LeBaptCode/PolySource/README.md

<h1> PolySource </h1>
<p>Année 2025-2026</p>
<p>Projet ELSE4 FISA Polytech Nice Sophia </p>

<p>Objectif: 
    <ul>
    <li>Monitoring d'une source</li>
    <li>mesure de hauteur d'eau</li>
    <li>mesure de débit</li>
    <li>détection de trop plein</li>
    <li>publication des mesures sur page web (GSM, MQTT, ...)</li>
    <li>gestion de l'énergie pour maximiser l’autonomie</li></ul></p>
