LeBaptCode/PolySource/RESSOURCES/Tuto/README.md

# Repertoir de tutoriels

Ce dossier contient les tutoriels de configurations des différents éléments du projet:

- Configuration du Raspberry Pi 5 pour héberger le serveur web et les services Telegraf et Grafana.
- Configuration du module GSM USR-DR154 pour qu'il puisse se connecter au broker MQTT HiveMQ Cloud et envoyer des données.
