LeBaptCode/PolySource/DOCS/AndyCLEMENT/Compte-Rendu-17.md

# Compte Rendu Semaine 14 / W17 (24/04/2026)

## Concevoir le tuto pour la configuration du module GSM USR-DR154

Puisqu'aujourd'hui, est la dernère séance de l'année, nous avons décidé de concevoir un tutoriel pour expliquer comment configurer le module GSM USR-DR154 pour que le groupe suivant puisse continuer le projet et avancer plus vite. Le tutoriel explique comment configurer le module GSM pour qu'il puisse se connecter au broker MQTT HiveMQ Cloud et envoyer des données. Le tutoriel est disponible sur le dépôt GitHub du projet, dans le dossier Ressource/tuto.

## Mise à jour du code

Mathis a modifer le code de l'ESP32 pour régler le problème du sonar. Il a réussi a avoir un code fonctionnel

## Prochaine séance

Continuer à travaille sur le code.
