LeBaptCode/PolySource/DOCS/BaptisteLECLERC/Seance11.md

# Séance du 19/02/2026

## 🎯 Objectifs de la séance

* Restaurer et stabiliser l'environnement système de la Raspberry Pi.

---
## 🛠️ Réalisations 

### Diagnostic et Résolution d'Incidents Système
La séance a été principalement consacrée à la résolution d'instabilités système majeures sur la Raspberry Pi :

* **Conflit d'Horloge & InfluxDB :** Un décalage critique de la date et de l'heure système empêchait le démarrage du service `InfluxDB`. Ce type de base de données "séries temporelles" requiert une synchronisation parfaite pour fonctionner.
* **Corruption suite au changement de localisation :** Une tentative de reconfiguration de la localisation (*locale*) a entraîné la perte de l'interface graphique  et la suppression accidentelle de répertoires du projet.
* **Restauration complète :** Afin de garantir la stabilité future, j'ai procédé à une réinstallation et une reconfiguration complète du système d'exploitation.

### Gestion des Sauvegardes et Reprise d'Activité
* **Analyse Post-Incident :** Malgré l'absence de mise à jour récente sur `GitHub`, j'ai pu m'appuyer sur une sauvegarde récente.
* **Réactivité :** Ma documentation des étapes de configuration précédentes a permis une réinstallation rapide des services et une réécriture efficace des dernières modifications.
* **État final :** À l'issue de la séance, la chaîne de données complète (`MQTT` → `Telegraf` → `InfluxDB` → `Grafana`) est de nouveau pleinement opérationnelle.

---

## ➡️ Prochaine séance

* **Cahier des charges PCB :** Lister les contraintes techniques pour la conception de la carte électronique :
    * Schéma d'intégration des composants (ESP32, capteurs, régulateurs).
    * Définition des dimensions et du boîtier pour garantir l'étanchéité et la protection en milieu extérieur.
