LeBaptCode/PolySource/DOCS/README.md

Ici sont stockés les rapports individuels de chacun des membres
