LeBaptCode/PolySource/RESSOURCES/Data-Sheet/README.md

# Ici sont stockés les datasheet de nos composants
