LeBaptCode/PolySource/DOCS/AndyCLEMENT/README.md

<h1> Depot personnel</h1>
<p> Ici sera stocké les rapports de Andy CLEMENT concernant le projet</p>
