LeBaptCode/PolySource/DOCS/MatthisGOMEZ/README.md

Ici je vais rentrer l'avancée de mes travaux personnels (même les tentatives et explorations de thème qui se sont soldées par un échec).
