LeBaptCode/PolySource/DOCS/AndyCLEMENT/Images/README.md

<h1>Ici sont stockés toute les images utilisées dans les rapports</h1>
