LeBaptCode/PolySource/DOCS/MatthisGOMEZ/ZSeance15.md

Le but cette fois-ci a été de faire un test en "condition réelle" avec : 
le gsm qui envoie les données en format json du sonar et du débit-mètre au broker en mqtt.

Verdict : test réussi, on a un projet fonctionnel.

Probleme : seulement un des deux gsm fonctionne nous n'avons pas trouvé le moyen de configurer le second.

Nous avons donc créer un tutoriel pour les prochaines personnes qui devront travailler sur le projet, ainsi il sera plus simple pour eux de configurer le gsm usr dsr4.
