LeBaptCode/PolySource/DOCS/BaptisteLECLERC/Seance15.md

# Séance du 10/04/2026

## 🎯 Objectifs de la séance
* Audit de performance et de stabilité.
* Optimiser l'interface utilisateur (UI) pour différentes tailles d'écran.

---

## 🛠️ Réalisations 

### Audit de performance et stabilité
Suite aux interventions thermiques des séances précédentes, j'ai effectué une phase de surveillance pour valider la robustesse de l'installation :
* **Analyse des ressources (htop) :** Surveillance de la charge CPU et de l'occupation mémoire. Aucun "memory leak" ni processus anormal n'a été détecté. 
* **Validation thermique :** Grafana est resté actif durant toute la séance sans provoquer de ralentissements. Le ventilateur n'est peut-être pas nécessaire pour les conditions actuelles, je ferai le test lors de la prochaine séance.

### Validation de la chaîne de données
* **Validation de l'interopérabilité "End-to-End" :** Lors des essais d'émission MQTT effectués par Andy, j'ai supervisé le flux de données sur l'ensemble de la stack technique. Ce test a confirmé le bon fonctionnement de toute la chaîne : la réception par le broker, le parsing via Telegraf, l'archivage dans InfluxDB et l'affichage dynamique en temps réel sur Grafana.

### Optimisation de l'interface (Responsive Design)
Pour garantir une exploitation optimale des données sur le terrain :
* **Adaptabilité du Dashboard :** J'ai retravaillé l'agencement des panneaux Grafana pour les rendre **responsives**. 
* **Flexibilité d'affichage :** Les grilles de visualisation s'adaptent désormais automatiquement à la taille de l'écran. Des tests complémentaires seront à prévoir sur différents écrans pour valider les points de rupture d'affichage.

---

## ➡️ Prochaine séance

* **Automatisation de la configuration :** Développement d'un script de déploiement automatique pour l'installation des dépendances système (Docker, outils de monitoring).
    * Finalisation du fichier `docker-compose.yml` pour permettre un déploiement "en un clic" de la stack T.I.G. (Telegraf, InfluxDB, Grafana).
* **Dossier de transfert et reproductibilité :**  Rédaction d'un guide `README.md` détaillant les étapes de mise en service à partir d'une installation vierge.
    * L'objectif est de garantir que le projet puisse être intégralement récupéré et déployé par un tiers en un minimum de temps.
