LeBaptCode/PolySource/DOCS/BaptisteLECLERC/Seance2.md

# Séance du 23/10/2025

## Objectif de la séance
Durant cette séance, j’ai poursuivi mes recherches sur la stack que nous allons utiliser pour l’interface web.

## Choix technologiques

### Hébergement et base de données
Nous avons choisi d’utiliser **Firebase** de **Google**, car il permet d’héberger gratuitement le site internet tout en offrant une base de données intégrée au même endroit.  
Ainsi, **Firebase** sera utilisé pour le **backend** du projet.

### Interface web (Frontend)
Pour la partie **frontend**, nous avons décidé d’utiliser **Vue.js**, un framework JavaScript léger et parfaitement adapté à notre cas d’usage.

### Librairies et composants
J’ai également recherché des librairies utiles pour les différents composants de l’interface.  
Je m’oriente vers la librairie **[shadcn/ui](https://ui.shadcn.com/)** pour la partie **UI**, car elle propose des composants déjà prêts, personnalisables, et visuellement cohérents.

Pour l’affichage des graphiques, je compte utiliser **[Chart.js](https://www.chartjs.org/)**, une librairie populaire et simple d’utilisation.

## Prochaine séance
Lors de la prochaine séance, je vais :
- Continuer la mise en place du projet.  
- Ajouter les différentes librairies nécessaires.  
- Commencer la conception du dashboard.
