LeBaptCode/PolySource/DOCS/BaptisteLECLERC/images/grafana_dashboard.png

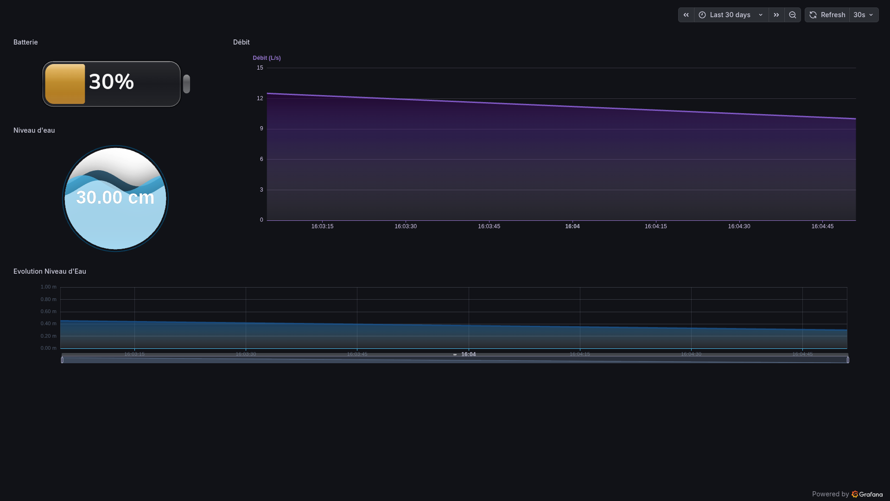
DOCS/BaptisteLECLERC/images/grafana_dashboard.png
