LeBaptCode/PolySource/DOCS/BaptisteLECLERC/images/hiveMq_Cloud.png

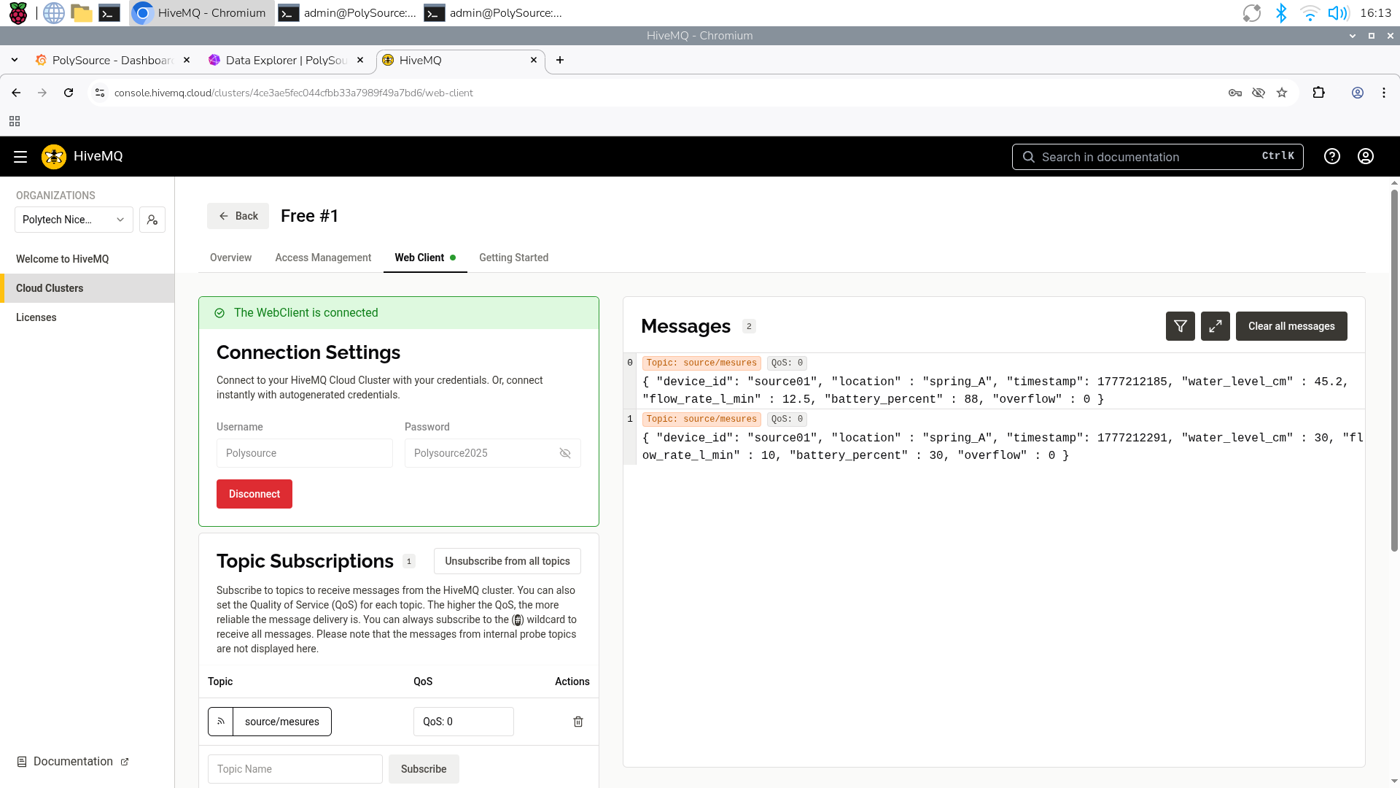
DOCS/BaptisteLECLERC/images/hiveMq_Cloud.png
