LeBaptCode/PolySource/DOCS/MatthisGOMEZ/1000021461.jpg

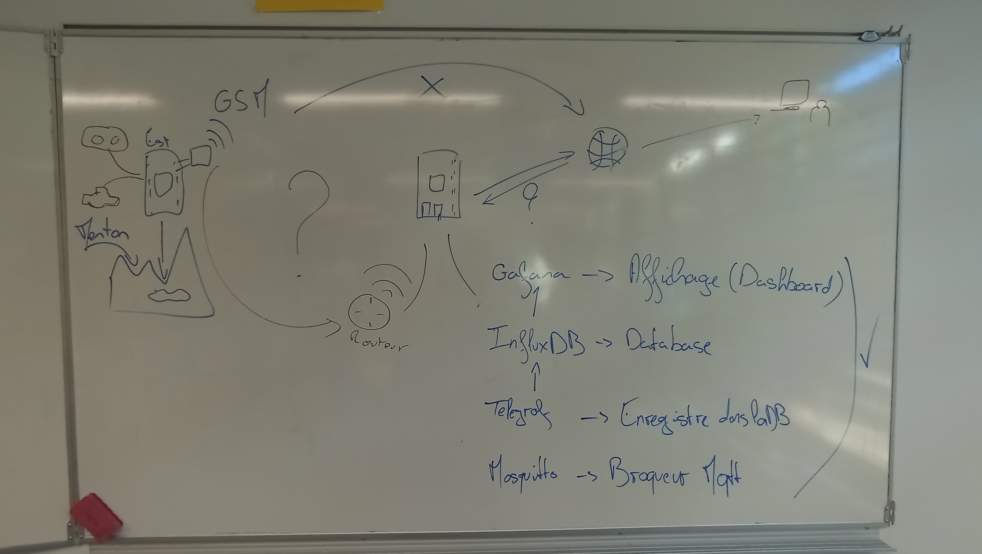
DOCS/MatthisGOMEZ/1000021461.jpg
