LeBaptCode/PolySource/RESSOURCES/Data-Sheet/Data-Sheet-DebitMetre.png

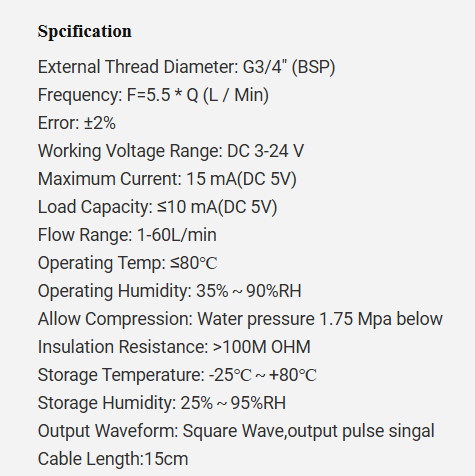
RESSOURCES/Data-Sheet/Data-Sheet-DebitMetre.png
