LeBaptCode/PolySource/ECOCONCEPTION/ecoconception_ACV.xlsx

Sheet: Bilan CO2eq Synthèse
BILAN ÉCOCONCEPTION — Empreinte Carbone Fabrication (Scope 3)
Méthode : ACV cradle-to-gate (ISO 14040/14044) | Scope 3 amont (fabrication) | Sources : ADEME Base Carbone, Ecoinvent 3.9, Littérature scientifique
Référentiel des facteurs d'émission utilisés
Catégorie de matériau / composant | Facteur CO2eq | Unité | Source
PCB basique (carte mère TV basique) | 444.0 | kg CO2eq/m² | ADEME Base Carbone
PCB dense / connecté (contrôleur LCD, carte connectée) | 866.0 | kg CO2eq/m² | ADEME Base Carbone
Wafer silicium — circuits intégrés (semi-conducteurs) | 5000.0 | kg CO2eq/m² | Littérature scientif. (200-27 000 MJ/cm², ~0,4 kgCO2/MJ)
Circuit intégré logique / réseau (par masse) | 80.7 | kg CO2eq/kg | ADEME Base Carbone / Boavizta
Composants passifs CMS (résistances, condensateurs, inductances) | 15.0 | kg CO2eq/kg | Ecoinvent 3.9
Connecteurs électroniques | 15.0 | kg CO2eq/kg | Ecoinvent 3.9
Plastiques injectés ABS / POM / PVC | 3.5 | kg CO2eq/kg | Ecoinvent 3.9
Caoutchouc synthétique EPDM | 3.2 | kg CO2eq/kg | Ecoinvent 3.9
Laiton (corps mécanique) | 3.8 | kg CO2eq/kg | Ecoinvent 3.9
Néodyme — terres rares (aimant NdFeB) | 35.0 | kg CO2eq/kg | Ecoinvent 3.9
Aluminium usiné primaire (électrolyse Hall-Héroult) | 14.5 | kg CO2eq/kg | Ecoinvent 3.9
Câble cuivre + isolant PVC | 5.0 | kg CO2eq/kg | Ecoinvent 3.9
Acier inoxydable | 2.0 | kg CO2eq/kg | Ecoinvent 3.9
Bilan CO2eq par carte / bloc fonctionnel (fabrication)
Composant / Carte | Référence | CO2eq estimé (kg CO2eq) | Part du système (%) | Principaux drivers d'impact | Levier d'écoconception prioritaire
ESP32 WiFi LoRa 32 V1 | Heltec HTIT-WB32 | 2.8849 | 9.6 | Wafer silicium ESP32-D0WDQ6 + SX1276 + PCB dense + OLED | Mode deep sleep < 5µA ; prolonger durée de vie ; réutiliser
Modem 4G LTE CAT1 | USR-DR154-E | 9.1308 | 30.5 | Module LTE interne (baseband) + PCB dense + boîtier ABS | Batching MQTT ; modes sommeil réseau LTE PSM/eDRX
Module LTE CAT1 DIP | WH-LTE-7S1-E | 3.8319 | 12.8 | SoC LTE ASR1601 (wafer) + PCB dense 4 couches | Évaluer si redondant avec DR154-E → mutualiser
Débitmètre | DIGITEN G3/4 | 0.6440 | 2.1 | Corps laiton 120g + aimant NdFeB (terres rares, 35 kg CO2eq/kg) | Conception modulaire : remplacer turbine seule ; éviter NdFeB
Capteur ultrasonique | HC-SR04 | 0.9934 | 3.3 | Cylindres aluminium (électrolyse) + céramique piézo PZT (Pb) | Choisir version RoHS sans plomb ; mode veille deep sleep
Raspberry Pi 4 Model B | BCM2711 + 4GB LPDDR4 | 12.4965 | 41.7 | BCM2711 SoC (12nm TSMC) + RAM LPDDR4 PoP + PCB 6 couches dense — carbone embarqué majeur | Levier principal : prolonger durée de vie (>5 ans) ; partager ressources calcul si Edge Computing
TOTAL SYSTÈME |  | 29.9815 | 100.0
⚠ Remarques méthodologiques
1. Périmètre : fabrication uniquement (Scope 3 amont, cradle-to-gate ISO 14040/14044). Phase d'usage (Scope 2) et fin de vie (DEEE) exclues.
2. Facteur wafer silicium (5 000 kg CO2eq/m²) estimé depuis 200-27 000 MJ/cm² (littérature) converti à ~0,4 kg CO2eq/MJ (mix électrique mondial).
3. Les masses sont estimées à partir des datasheets ; des pesées réelles amélioreraient la précision du bilan.
4. Matériaux critiques identifiés : néodyme (aimant débitmètre, 35 kg CO2eq/kg) et aluminium primaire (transducteurs HC-SR04, 14,5 kg CO2eq/kg).
5. Levier principal : doubler la durée de vie divise par 2 l'impact annualisé. Priorité : modes veille profonde + architecture logicielle économe.

Sheet: Systeme complet
Database | ESOS-Formation
format | Excel spreadsheet
Activity | Système de surveillance de source d'eau
code | surveillance-source-eau
Exchanges
name | alt-name | amount | unit | database | categories | location | type | uncertainty type | loc | scale | shape | minimum | maximum | masse estimée (kg) | facteur CO2eq (kg CO2eq/kg ou /m²) | source facteur | CO2eq estimé (kg CO2eq)
Système de surveillance de source d'eau |  | 1 | unit | ESOS-Formation |  | France | production | 0 | (Unknown) | (Unknown) | (Unknown) | (Unknown) | (Unknown)
ESP32 WiFi LoRa 32 V1 board production | Heltec LoRa 32 | 1 | unit | ESOS-Formation |  | GLO | technosphere | 0 | (Unknown) | (Unknown) | (Unknown) | (Unknown) | (Unknown)
Modem 4G LTE CAT1 production | USR-DR154-E | 1 | unit | ESOS-Formation |  | GLO | technosphere | 0 | (Unknown) | (Unknown) | (Unknown) | (Unknown) | (Unknown)
Module LTE CAT1 DIP production | WH-LTE-7S1-E | 1 | unit | ESOS-Formation |  | GLO | technosphere | 0 | (Unknown) | (Unknown) | (Unknown) | (Unknown) | (Unknown)
Capteur débitmètre production | DIGITEN G3/4 | 1 | unit | ESOS-Formation |  | GLO | technosphere | 0 | (Unknown) | (Unknown) | (Unknown) | (Unknown) | (Unknown)
Capteur ultrasonique production | HC-SR04 | 1 | unit | ESOS-Formation |  | GLO | technosphere | 0 | (Unknown) | (Unknown) | (Unknown) | (Unknown) | (Unknown)

Sheet: ESP32 WiFi LoRa 32 V1
Database | ESOS-Formation
format | Excel spreadsheet
Activity | ESP32 WiFi LoRa 32 V1 board production
code | ESP32-WiFi-LoRa32-V1
Exchanges
name | alt-name | amount | unit | database | categories | location | type | uncertainty type | loc | scale | shape | minimum | maximum | masse estimée (kg) | facteur CO2eq (kg CO2eq/kg ou /m²) | source facteur | CO2eq estimé (kg CO2eq)
ESP32 WiFi LoRa 32 V1 board production |  | 1 | unit | ESOS-Formation |  | GLO | production | 0 | (Unknown) | (Unknown) | (Unknown) | (Unknown) | (Unknown)
market for printed wiring board, for surface mounting, Pb free surface | PCB 4 layers 51x25mm | 0.001275 | square meter | ecoinvent-391-cutoff | pcb | GLO | technosphere | 0 | (Unknown) | (Unknown) | (Unknown) | (Unknown) | (Unknown) | 0.001275 | 866.0 | ADEME Base Carbone (PCB dense connecté) | 1.104150
market for mounting, surface mount technology, Pb-free solder | PCB SMT assembly | 0.001275 | square meter | ecoinvent-391-cutoff | pcb | GLO | technosphere | 0 | (Unknown) | (Unknown) | (Unknown) | (Unknown) | (Unknown) | 0.001275 | 866.0 | ADEME Base Carbone (PCB dense connecté) | 1.104150
market for wafer, fabricated, for integrated circuit | ESP32-D0WDQ6 QFN-48 | 3.6e-05 | square meter | ecoinvent-391-cutoff | ic | GLO | technosphere | 0 | (Unknown) | (Unknown) | (Unknown) | (Unknown) | (Unknown) | 0.000036 | 5000.0 | Littérature scientif. (200-27 000 MJ/cm²) | 0.180000
market for wafer, fabricated, for integrated circuit | SX1276 LoRa QFN-28 | 2.5e-05 | square meter | ecoinvent-391-cutoff | ic | GLO | technosphere | 0 | (Unknown) | (Unknown) | (Unknown) | (Unknown) | (Unknown) | 0.000025 | 5000.0 | Littérature scientif. (200-27 000 MJ/cm²) | 0.125000
market for wafer, fabricated, for integrated circuit | CP2102 USB-UART QFN-28 | 2.5e-05 | square meter | ecoinvent-391-cutoff | ic | GLO | technosphere | 0 | (Unknown) | (Unknown) | (Unknown) | (Unknown) | (Unknown) | 0.000025 | 5000.0 | Littérature scientif. (200-27 000 MJ/cm²) | 0.125000
market for integrated circuit, logic type | SSD1306 OLED driver COG | 0.00024 | kilogram | ecoinvent-391-cutoff | ic | GLO | technosphere | 0 | (Unknown) | (Unknown) | (Unknown) | (Unknown) | (Unknown) | 0.000240 | 80.7 | ADEME / Boavizta (équip. réseau) | 0.019368
market for integrated circuit, logic type | TP4054 LiPo charger SOT-23-5 | 6.3e-06 | kilogram | ecoinvent-391-cutoff | ic | GLO | technosphere | 0 | (Unknown) | (Unknown) | (Unknown) | (Unknown) | (Unknown) | 0.000006 | 80.7 | ADEME / Boavizta (équip. réseau) | 0.000508
market for liquid crystal display production, unmounted | OLED display 0.96inch | 0.0015 | kilogram | ecoinvent-391-cutoff | ic | GLO | technosphere | 0 | (Unknown) | (Unknown) | (Unknown) | (Unknown) | (Unknown) | 0.001500 | 80.7 | ADEME / Boavizta (équip. réseau) | 0.121050
market for electric connector, peripheral type buss | Connecteur micro-USB | 0.00023 | kilogram | ecoinvent-391-cutoff | peripherial | GLO | technosphere | 0 | (Unknown) | (Unknown) | (Unknown) | (Unknown) | (Unknown) | 0.000230 | 15.0 | Ecoinvent 3.9 (connecteurs électroniques) | 0.003450
market for electric connector, peripheral component interconnect buss | Connecteur batterie SH1.25-2 | 8e-05 | kilogram | ecoinvent-391-cutoff | peripherial | GLO | technosphere | 0 | (Unknown) | (Unknown) | (Unknown) | (Unknown) | (Unknown) | 0.000080 | 15.0 | Ecoinvent 3.9 (connecteurs électroniques) | 0.001200
market for electric connector, peripheral component interconnect buss | Headers 2.54mm 2x19p | 0.00071 | kilogram | ecoinvent-391-cutoff | peripherial | GLO | technosphere | 0 | (Unknown) | (Unknown) | (Unknown) | (Unknown) | (Unknown) | 0.000710 | 15.0 | Ecoinvent 3.9 (connecteurs électroniques) | 0.010650
market for electric connector, peripheral component interconnect buss | Connecteur IPEX U.FL LoRa | 0.00057 | kilogram | ecoinvent-391-cutoff | peripherial | GLO | technosphere | 0 | (Unknown) | (Unknown) | (Unknown) | (Unknown) | (Unknown) | 0.000570 | 15.0 | Ecoinvent 3.9 (connecteurs électroniques) | 0.008550
market for electric connector, peripheral type buss | Antenne WiFi spring 2.4GHz | 0.001 | kilogram | ecoinvent-391-cutoff | peripherial | GLO | technosphere | 0 | (Unknown) | (Unknown) | (Unknown) | (Unknown) | (Unknown) | 0.001000 | 15.0 | Ecoinvent 3.9 (connecteurs électroniques) | 0.015000
market for resistor, surface-mounted | resistor 0402 | 9.8e-05 | kilogram | ecoinvent-391-cutoff | passive-component | GLO | technosphere | 0 | (Unknown) | (Unknown) | (Unknown) | (Unknown) | (Unknown) | 0.000098 | 15.0 | Ecoinvent 3.9 (composants passifs CMS) | 0.001470
market for capacitor, for surface-mounting | capacitor 0402 | 9e-05 | kilogram | ecoinvent-391-cutoff | passive-component | GLO | technosphere | 0 | (Unknown) | (Unknown) | (Unknown) | (Unknown) | (Unknown) | 0.000090 | 15.0 | Ecoinvent 3.9 (composants passifs CMS) | 0.001350
market for capacitor, tantalum-, for through-hole mounting | capacitor tantalum 1206 | 5.4e-05 | kilogram | ecoinvent-391-cutoff | passive-component | GLO | technosphere | 0 | (Unknown) | (Unknown) | (Unknown) | (Unknown) | (Unknown) | 0.000054 | 15.0 | Ecoinvent 3.9 (composants passifs CMS) | 0.000810
market for inductor, low value multilayer chip | inductor 0603 RF filter | 2e-05 | kilogram | ecoinvent-391-cutoff | passive-component | GLO | technosphere | 0 | (Unknown) | (Unknown) | (Unknown) | (Unknown) | (Unknown) | 0.000020 | 15.0 | Ecoinvent 3.9 (composants passifs CMS) | 0.000300
market for diode, glass-, for surface-mounting | LED status 0603 | 8e-05 | kilogram | ecoinvent-391-cutoff | passive-component | GLO | technosphere | 0 | (Unknown) | (Unknown) | (Unknown) | (Unknown) | (Unknown) | 0.000080 | 15.0 | Ecoinvent 3.9 (composants passifs CMS) | 0.001200
market for diode, glass-, for surface-mounting | diode Schottky SOD-323 | 6.6e-05 | kilogram | ecoinvent-391-cutoff | passive-component | GLO | technosphere | 0 | (Unknown) | (Unknown) | (Unknown) | (Unknown) | (Unknown) | 0.000066 | 15.0 | Ecoinvent 3.9 (composants passifs CMS) | 0.000990
market for transistor, surface-mounted | transistor SOT-23 | 1.6e-05 | kilogram | ecoinvent-391-cutoff | passive-component | GLO | technosphere | 0 | (Unknown) | (Unknown) | (Unknown) | (Unknown) | (Unknown) | 0.000016 | 15.0 | Ecoinvent 3.9 (composants passifs CMS) | 0.000240
market for switch, toggle type | push button RST/PRG x2 | 0.0008 | kilogram | ecoinvent-391-cutoff | passive-component | GLO | technosphere | 0 | (Unknown) | (Unknown) | (Unknown) | (Unknown) | (Unknown) | 0.000800 | 15.0 | Ecoinvent 3.9 (composants passifs CMS) | 0.012000
market for integrated circuit, logic type | crystal 32kHz | 0.0006 | kilogram | ecoinvent-391-cutoff | ic | GLO | technosphere | 0 | (Unknown) | (Unknown) | (Unknown) | (Unknown) | (Unknown) | 0.000600 | 80.7 | ADEME / Boavizta (équip. réseau) | 0.048420
TOTAL CO2eq estimé (fabrication) |  |  |  |  |  |  |  |  |  |  |  |  |  |  |  |  | 2.8849

Sheet: USR-DR154-E Modem 4G LTE
Database | ESOS-Formation
format | Excel spreadsheet
Activity | Modem 4G LTE CAT1 production
code | USR-DR154-E-production
Exchanges
name | alt-name | amount | unit | database | categories | location | type | uncertainty type | loc | scale | shape | minimum | maximum | masse estimée (kg) | facteur CO2eq (kg CO2eq/kg ou /m²) | source facteur | CO2eq estimé (kg CO2eq)
Modem 4G LTE CAT1 production |  | 1 | unit | ESOS-Formation |  | GLO | production | 0 | (Unknown) | (Unknown) | (Unknown) | (Unknown) | (Unknown)
market for printed wiring board, for surface mounting, Pb free surface | PCB 4 layers 85x34mm | 0.00289 | square meter | ecoinvent-391-cutoff | pcb | GLO | technosphere | 0 | (Unknown) | (Unknown) | (Unknown) | (Unknown) | (Unknown) | 0.002890 | 866.0 | ADEME Base Carbone (PCB dense connecté) | 2.502740
market for mounting, surface mount technology, Pb-free solder | PCB SMT assembly | 0.00289 | square meter | ecoinvent-391-cutoff | pcb | GLO | technosphere | 0 | (Unknown) | (Unknown) | (Unknown) | (Unknown) | (Unknown) | 0.002890 | 866.0 | ADEME Base Carbone (PCB dense connecté) | 2.502740
market for wafer, fabricated, for integrated circuit | Module LTE CAT1 interne EC21 | 0.000784 | square meter | ecoinvent-391-cutoff | ic | GLO | technosphere | 0 | (Unknown) | (Unknown) | (Unknown) | (Unknown) | (Unknown) | 0.000784 | 5000.0 | Littérature scientif. (200-27 000 MJ/cm²) | 3.920000
market for integrated circuit, logic type | RS485 transceiver SOIC-8 | 0.0011 | kilogram | ecoinvent-391-cutoff | ic | GLO | technosphere | 0 | (Unknown) | (Unknown) | (Unknown) | (Unknown) | (Unknown) | 0.001100 | 80.7 | ADEME / Boavizta (équip. réseau) | 0.088770
market for integrated circuit, logic type | DC-DC régulateur 5-24V SOT-23-5 | 6.3e-06 | kilogram | ecoinvent-391-cutoff | ic | GLO | technosphere | 0 | (Unknown) | (Unknown) | (Unknown) | (Unknown) | (Unknown) | 0.000006 | 80.7 | ADEME / Boavizta (équip. réseau) | 0.000508
market for integrated circuit, logic type | Watchdog IC SOT-23-3 | 1.6e-05 | kilogram | ecoinvent-391-cutoff | ic | GLO | technosphere | 0 | (Unknown) | (Unknown) | (Unknown) | (Unknown) | (Unknown) | 0.000016 | 80.7 | ADEME / Boavizta (équip. réseau) | 0.001291
market for electric connector, peripheral component interconnect buss | Terminal RS485 3 pins screwless | 0.00058 | kilogram | ecoinvent-391-cutoff | peripherial | GLO | technosphere | 0 | (Unknown) | (Unknown) | (Unknown) | (Unknown) | (Unknown) | 0.000580 | 15.0 | Ecoinvent 3.9 (connecteurs électroniques) | 0.008700
market for electric connector, peripheral component interconnect buss | Terminal alimentation 2 pins | 0.0002 | kilogram | ecoinvent-391-cutoff | peripherial | GLO | technosphere | 0 | (Unknown) | (Unknown) | (Unknown) | (Unknown) | (Unknown) | 0.000200 | 15.0 | Ecoinvent 3.9 (connecteurs électroniques) | 0.003000
market for electric connector, peripheral type buss | Connecteur SMA antenne 4G | 0.003 | kilogram | ecoinvent-391-cutoff | peripherial | GLO | technosphere | 0 | (Unknown) | (Unknown) | (Unknown) | (Unknown) | (Unknown) | 0.003000 | 15.0 | Ecoinvent 3.9 (connecteurs électroniques) | 0.045000
market for electric connector, peripheral component interconnect buss | Slot SIM MINI 2FF | 0.00054 | kilogram | ecoinvent-391-cutoff | peripherial | GLO | technosphere | 0 | (Unknown) | (Unknown) | (Unknown) | (Unknown) | (Unknown) | 0.000540 | 15.0 | Ecoinvent 3.9 (connecteurs électroniques) | 0.008100
market for diode, glass-, for surface-mounting | LED indicateurs x3 | 0.00022 | kilogram | ecoinvent-391-cutoff | passive-component | GLO | technosphere | 0 | (Unknown) | (Unknown) | (Unknown) | (Unknown) | (Unknown) | 0.000220 | 15.0 | Ecoinvent 3.9 (composants passifs CMS) | 0.003300
market for capacitor, for surface-mounting | capacitor 0402 | 2.7e-05 | kilogram | ecoinvent-391-cutoff | passive-component | GLO | technosphere | 0 | (Unknown) | (Unknown) | (Unknown) | (Unknown) | (Unknown) | 0.000027 | 15.0 | Ecoinvent 3.9 (composants passifs CMS) | 0.000405
market for capacitor, tantalum-, for through-hole mounting | capacitor tantalum filtrage | 5.4e-05 | kilogram | ecoinvent-391-cutoff | passive-component | GLO | technosphere | 0 | (Unknown) | (Unknown) | (Unknown) | (Unknown) | (Unknown) | 0.000054 | 15.0 | Ecoinvent 3.9 (composants passifs CMS) | 0.000810
market for resistor, surface-mounted | resistor 0402 | 4.2e-05 | kilogram | ecoinvent-391-cutoff | passive-component | GLO | technosphere | 0 | (Unknown) | (Unknown) | (Unknown) | (Unknown) | (Unknown) | 0.000042 | 15.0 | Ecoinvent 3.9 (composants passifs CMS) | 0.000630
market for inductor, low value multilayer chip | inductor 1008 DC-DC | 0.00011 | kilogram | ecoinvent-391-cutoff | passive-component | GLO | technosphere | 0 | (Unknown) | (Unknown) | (Unknown) | (Unknown) | (Unknown) | 0.000110 | 15.0 | Ecoinvent 3.9 (composants passifs CMS) | 0.001650
market for acrylonitrile-butadiene-styrene copolymer, bulk polymerised | Boîtier ABS DIN rail | 0.012 | kilogram | ecoinvent-391-cutoff | passive-component | GLO | technosphere | 0 | (Unknown) | (Unknown) | (Unknown) | (Unknown) | (Unknown) | 0.012000 | 3.5 | Ecoinvent 3.9 (ABS moulé injection) | 0.042000
market for diode, glass-, for surface-mounting | diode TVS protection RS485 | 7.4e-05 | kilogram | ecoinvent-391-cutoff | passive-component | GLO | technosphere | 0 | (Unknown) | (Unknown) | (Unknown) | (Unknown) | (Unknown) | 0.000074 | 15.0 | Ecoinvent 3.9 (composants passifs CMS) | 0.001110
TOTAL CO2eq estimé (fabrication) |  |  |  |  |  |  |  |  |  |  |  |  |  |  |  |  | 9.1308

Sheet: WH-LTE-7S1-E Module LTE
Database | ESOS-Formation
format | Excel spreadsheet
Activity | Module LTE CAT1 DIP production
code | WH-LTE-7S1-E-production
Exchanges
name | alt-name | amount | unit | database | categories | location | type | uncertainty type | loc | scale | shape | minimum | maximum | masse estimée (kg) | facteur CO2eq (kg CO2eq/kg ou /m²) | source facteur | CO2eq estimé (kg CO2eq)
Module LTE CAT1 DIP production |  | 1 | unit | ESOS-Formation |  | GLO | production | 0 | (Unknown) | (Unknown) | (Unknown) | (Unknown) | (Unknown)
market for printed wiring board, for surface mounting, Pb free surface | PCB 4 layers 44.4x41.8mm | 0.001855 | square meter | ecoinvent-391-cutoff | pcb | GLO | technosphere | 0 | (Unknown) | (Unknown) | (Unknown) | (Unknown) | (Unknown) | 0.001855 | 866.0 | ADEME Base Carbone (PCB dense connecté) | 1.606430
market for mounting, surface mount technology, Pb-free solder | PCB SMT assembly | 0.001855 | square meter | ecoinvent-391-cutoff | pcb | GLO | technosphere | 0 | (Unknown) | (Unknown) | (Unknown) | (Unknown) | (Unknown) | 0.001855 | 866.0 | ADEME Base Carbone (PCB dense connecté) | 1.606430
market for wafer, fabricated, for integrated circuit | SoC LTE CAT1 QFN-72 (ASR1601) | 0.0001 | square meter | ecoinvent-391-cutoff | ic | GLO | technosphere | 0 | (Unknown) | (Unknown) | (Unknown) | (Unknown) | (Unknown) | 0.000100 | 5000.0 | Littérature scientif. (200-27 000 MJ/cm²) | 0.500000
market for integrated circuit, memory type | Flash NOR 8MB SOIC-8 | 0.0011 | kilogram | ecoinvent-391-cutoff | ic | GLO | technosphere | 0 | (Unknown) | (Unknown) | (Unknown) | (Unknown) | (Unknown) | 0.001100 | 80.7 | ADEME / Boavizta | 0.088770
market for integrated circuit, logic type | Régulateur DC-DC buck SOT-23-5 | 6.3e-06 | kilogram | ecoinvent-391-cutoff | ic | GLO | technosphere | 0 | (Unknown) | (Unknown) | (Unknown) | (Unknown) | (Unknown) | 0.000006 | 80.7 | ADEME / Boavizta (équip. réseau) | 0.000508
market for electric connector, peripheral component interconnect buss | Slot SIM MINI 2FF | 0.00054 | kilogram | ecoinvent-391-cutoff | peripherial | GLO | technosphere | 0 | (Unknown) | (Unknown) | (Unknown) | (Unknown) | (Unknown) | 0.000540 | 15.0 | Ecoinvent 3.9 (connecteurs électroniques) | 0.008100
market for electric connector, peripheral component interconnect buss | Connecteur IPEX U.FL antenne | 0.00057 | kilogram | ecoinvent-391-cutoff | peripherial | GLO | technosphere | 0 | (Unknown) | (Unknown) | (Unknown) | (Unknown) | (Unknown) | 0.000570 | 15.0 | Ecoinvent 3.9 (connecteurs électroniques) | 0.008550
market for electric connector, peripheral component interconnect buss | Pins DIP-24 2.54mm | 0.0002 | kilogram | ecoinvent-391-cutoff | peripherial | GLO | technosphere | 0 | (Unknown) | (Unknown) | (Unknown) | (Unknown) | (Unknown) | 0.000200 | 15.0 | Ecoinvent 3.9 (connecteurs électroniques) | 0.003000
market for diode, glass-, for surface-mounting | LED indicateurs 0603 x3 | 0.00024 | kilogram | ecoinvent-391-cutoff | passive-component | GLO | technosphere | 0 | (Unknown) | (Unknown) | (Unknown) | (Unknown) | (Unknown) | 0.000240 | 15.0 | Ecoinvent 3.9 (composants passifs CMS) | 0.003600
market for capacitor, for surface-mounting | capacitor 0402 | 2.7e-05 | kilogram | ecoinvent-391-cutoff | passive-component | GLO | technosphere | 0 | (Unknown) | (Unknown) | (Unknown) | (Unknown) | (Unknown) | 0.000027 | 15.0 | Ecoinvent 3.9 (composants passifs CMS) | 0.000405
market for capacitor, tantalum-, for through-hole mounting | capacitor tantalum 2312 | 0.0003 | kilogram | ecoinvent-391-cutoff | passive-component | GLO | technosphere | 0 | (Unknown) | (Unknown) | (Unknown) | (Unknown) | (Unknown) | 0.000300 | 15.0 | Ecoinvent 3.9 (composants passifs CMS) | 0.004500
market for resistor, surface-mounted | resistor 0402 | 2e-05 | kilogram | ecoinvent-391-cutoff | passive-component | GLO | technosphere | 0 | (Unknown) | (Unknown) | (Unknown) | (Unknown) | (Unknown) | 0.000020 | 15.0 | Ecoinvent 3.9 (composants passifs CMS) | 0.000300
market for inductor, low value multilayer chip | inductor 0603 filtrage | 2e-05 | kilogram | ecoinvent-391-cutoff | passive-component | GLO | technosphere | 0 | (Unknown) | (Unknown) | (Unknown) | (Unknown) | (Unknown) | 0.000020 | 15.0 | Ecoinvent 3.9 (composants passifs CMS) | 0.000300
market for diode, glass-, for surface-mounting | diode ESD protection SOD-323 | 6.6e-05 | kilogram | ecoinvent-391-cutoff | passive-component | GLO | technosphere | 0 | (Unknown) | (Unknown) | (Unknown) | (Unknown) | (Unknown) | 0.000066 | 15.0 | Ecoinvent 3.9 (composants passifs CMS) | 0.000990
TOTAL CO2eq estimé (fabrication) |  |  |  |  |  |  |  |  |  |  |  |  |  |  |  |  | 3.8319

Sheet: Débitmètre DIGITEN G3-4
Database | ESOS-Formation
format | Excel spreadsheet
Activity | Capteur débitmètre production
code | Debitmetre-DIGITEN-G34
Exchanges
name | alt-name | amount | unit | database | categories | location | type | uncertainty type | loc | scale | shape | minimum | maximum | masse estimée (kg) | facteur CO2eq (kg CO2eq/kg ou /m²) | source facteur | CO2eq estimé (kg CO2eq)
Capteur débitmètre production |  | 1 | unit | ESOS-Formation |  | GLO | production | 0 | (Unknown) | (Unknown) | (Unknown) | (Unknown) | (Unknown)
market for brass | Corps laiton G3/4 | 0.12 | kilogram | ecoinvent-391-cutoff | metal | GLO | technosphere | 0 | (Unknown) | (Unknown) | (Unknown) | (Unknown) | (Unknown) | 0.120000 | 3.8 | Ecoinvent 3.9 (laiton) | 0.456000
market for acrylonitrile-butadiene-styrene copolymer, bulk polymerised | Turbine ABS | 0.005 | kilogram | ecoinvent-391-cutoff | plastic | GLO | technosphere | 0 | (Unknown) | (Unknown) | (Unknown) | (Unknown) | (Unknown) | 0.005000 | 3.5 | Ecoinvent 3.9 (ABS moulé injection) | 0.017500
market for neodymium | Aimant NdFeB permanent | 0.002 | kilogram | ecoinvent-391-cutoff | metal | GLO | technosphere | 0 | (Unknown) | (Unknown) | (Unknown) | (Unknown) | (Unknown) | 0.002000 | 35.0 | Ecoinvent 3.9 (néodyme - terres rares) | 0.070000
market for integrated circuit, logic type | Capteur Hall IC SOT-23-3 | 1.6e-05 | kilogram | ecoinvent-391-cutoff | ic | GLO | technosphere | 0 | (Unknown) | (Unknown) | (Unknown) | (Unknown) | (Unknown) | 0.000016 | 80.7 | ADEME / Boavizta (équip. réseau) | 0.001291
market for printed wiring board, for surface mounting, Pb free surface | PCB mini capteur Hall | 4e-05 | square meter | ecoinvent-391-cutoff | pcb | GLO | technosphere | 0 | (Unknown) | (Unknown) | (Unknown) | (Unknown) | (Unknown) | 0.000040 | 444.0 | ADEME Base Carbone (PCB basique TV) | 0.017760
market for cable, ribbon cable, 20-pin, with plugs | Câble 3 fils 30cm dupont | 0.015 | kilogram | ecoinvent-391-cutoff | peripherial | GLO | technosphere | 0 | (Unknown) | (Unknown) | (Unknown) | (Unknown) | (Unknown) | 0.015000 | 5.0 | Ecoinvent 3.9 (câble cuivre + isolant PVC) | 0.075000
market for synthetic rubber | Joint O-ring EPDM x2 | 0.002 | kilogram | ecoinvent-391-cutoff | plastic | GLO | technosphere | 0 | (Unknown) | (Unknown) | (Unknown) | (Unknown) | (Unknown) | 0.002000 | 3.2 | Ecoinvent 3.9 (caoutchouc synthétique) | 0.006400
market for resistor, surface-mounted | resistor pull-up 10kΩ 0402 | 6.5e-07 | kilogram | ecoinvent-391-cutoff | passive-component | GLO | technosphere | 0 | (Unknown) | (Unknown) | (Unknown) | (Unknown) | (Unknown) | 0.000001 | 15.0 | Ecoinvent 3.9 (composants passifs CMS) | 0.000010
TOTAL CO2eq estimé (fabrication) |  |  |  |  |  |  |  |  |  |  |  |  |  |  |  |  | 0.6440

Sheet: Capteur ultrasonique HC-SR04
Database | ESOS-Formation
format | Excel spreadsheet
Activity | Capteur ultrasonique production
code | Capteur-ultrasonic-HC-SR04
Exchanges
name | alt-name | amount | unit | database | categories | location | type | uncertainty type | loc | scale | shape | minimum | maximum | masse estimée (kg) | facteur CO2eq (kg CO2eq/kg ou /m²) | source facteur | CO2eq estimé (kg CO2eq)
Capteur ultrasonique production |  | 1 | unit | ESOS-Formation |  | GLO | production | 0 | (Unknown) | (Unknown) | (Unknown) | (Unknown) | (Unknown)
market for printed wiring board, for surface mounting, Pb free surface | PCB 2 layers 45x20mm | 0.0009 | square meter | ecoinvent-391-cutoff | pcb | GLO | technosphere | 0 | (Unknown) | (Unknown) | (Unknown) | (Unknown) | (Unknown) | 0.000900 | 444.0 | ADEME Base Carbone (PCB basique TV) | 0.399600
market for mounting, surface mount technology, Pb-free solder | PCB THT assembly | 0.0009 | square meter | ecoinvent-391-cutoff | pcb | GLO | technosphere | 0 | (Unknown) | (Unknown) | (Unknown) | (Unknown) | (Unknown) | 0.000900 | 444.0 | ADEME Base Carbone (PCB basique TV) | 0.399600
market for integrated circuit, logic type | Transducteur piézo émetteur T40-16 (alum.) | 0.0035 | kilogram | ecoinvent-391-cutoff | ic | GLO | technosphere | 0 | (Unknown) | (Unknown) | (Unknown) | (Unknown) | (Unknown) | 0.003500 | 14.5 | Ecoinvent 3.9 (aluminium primaire) | 0.050750
market for integrated circuit, logic type | Transducteur piézo récepteur R40-16 (alum.) | 0.0035 | kilogram | ecoinvent-391-cutoff | ic | GLO | technosphere | 0 | (Unknown) | (Unknown) | (Unknown) | (Unknown) | (Unknown) | 0.003500 | 14.5 | Ecoinvent 3.9 (aluminium primaire) | 0.050750
market for integrated circuit, logic type | IC contrôle timing DIP-8 (NE555) | 0.0011 | kilogram | ecoinvent-391-cutoff | ic | GLO | technosphere | 0 | (Unknown) | (Unknown) | (Unknown) | (Unknown) | (Unknown) | 0.001100 | 80.7 | ADEME / Boavizta (équip. réseau) | 0.088770
market for resistor, surface-mounted | resistor 0402/THT | 2e-05 | kilogram | ecoinvent-391-cutoff | passive-component | GLO | technosphere | 0 | (Unknown) | (Unknown) | (Unknown) | (Unknown) | (Unknown) | 0.000020 | 15.0 | Ecoinvent 3.9 (composants passifs CMS) | 0.000300
market for capacitor, for surface-mounting | capacitor 0402 | 9e-06 | kilogram | ecoinvent-391-cutoff | passive-component | GLO | technosphere | 0 | (Unknown) | (Unknown) | (Unknown) | (Unknown) | (Unknown) | 0.000009 | 15.0 | Ecoinvent 3.9 (composants passifs CMS) | 0.000135
market for electric connector, peripheral component interconnect buss | Header 4 pins 2.54mm | 0.00015 | kilogram | ecoinvent-391-cutoff | peripherial | GLO | technosphere | 0 | (Unknown) | (Unknown) | (Unknown) | (Unknown) | (Unknown) | 0.000150 | 15.0 | Ecoinvent 3.9 (connecteurs électroniques) | 0.002250
market for diode, glass-, for surface-mounting | LED alimentation 3mm | 8e-05 | kilogram | ecoinvent-391-cutoff | passive-component | GLO | technosphere | 0 | (Unknown) | (Unknown) | (Unknown) | (Unknown) | (Unknown) | 0.000080 | 15.0 | Ecoinvent 3.9 (composants passifs CMS) | 0.001200
TOTAL CO2eq estimé (fabrication) |  |  |  |  |  |  |  |  |  |  |  |  |  |  |  |  | 0.9934

Sheet: Raspberry Pi 4 Model B
Database | ESOS-Formation
format | Excel spreadsheet
Activity | Raspberry Pi 4 Model B production
code | RPi4B-production
Exchanges
name | alt-name | amount | unit | database | categories | location | type | uncertainty type | loc | scale | shape | minimum | maximum | masse estimée (kg) | facteur CO2eq (kg CO2eq/kg ou /m²) | source facteur | CO2eq estimé (kg CO2eq)
Raspberry Pi 4 Model B production |  | 1 | unit | ESOS-Formation |  | United Kingdom | production | 0 | (Unknown) | (Unknown) | (Unknown) | (Unknown) | (Unknown)
market for printed wiring board, for surface mounting, Pb free surface | PCB 6 layers 85x56mm | 0.00476 | square meter | ecoinvent-391-cutoff | pcb | GLO | technosphere | 0 | (Unknown) | (Unknown) | (Unknown) | (Unknown) | (Unknown) | 0.004760 | 866.0 | ADEME Base Carbone (PCB dense connecté) | 4.122160
market for mounting, surface mount technology, Pb-free solder | PCB SMT assembly | 0.00476 | square meter | ecoinvent-391-cutoff | pcb | GLO | technosphere | 0 | (Unknown) | (Unknown) | (Unknown) | (Unknown) | (Unknown) | 0.004760 | 866.0 | ADEME Base Carbone (PCB dense connecté) | 4.122160
market for wafer, fabricated, for integrated circuit | BCM2711 SoC FCBGA-1651 (12nm, 16x16mm) | 0.000256 | square meter | ecoinvent-391-cutoff | ic | GLO | technosphere | 0 | (Unknown) | (Unknown) | (Unknown) | (Unknown) | (Unknown) | 0.000256 | 5000.0 | Littérature scientif. (200-27 000 MJ/cm²) | 1.280000
market for wafer, fabricated, for integrated circuit | LPDDR4 4GB RAM PoP x2 (2×120mm²) | 0.00024 | square meter | ecoinvent-391-cutoff | ic | GLO | technosphere | 0 | (Unknown) | (Unknown) | (Unknown) | (Unknown) | (Unknown) | 0.000240 | 5000.0 | Littérature scientif. (200-27 000 MJ/cm²) | 1.200000
market for wafer, fabricated, for integrated circuit | CYW43455 WiFi/BT SiP (8x8mm) | 6.4e-05 | square meter | ecoinvent-391-cutoff | ic | GLO | technosphere | 0 | (Unknown) | (Unknown) | (Unknown) | (Unknown) | (Unknown) | 0.000064 | 5000.0 | Littérature scientif. (200-27 000 MJ/cm²) | 0.320000
market for wafer, fabricated, for integrated circuit | VL805 USB3 Hub QFN-64 (9x9mm) | 8.1e-05 | square meter | ecoinvent-391-cutoff | ic | GLO | technosphere | 0 | (Unknown) | (Unknown) | (Unknown) | (Unknown) | (Unknown) | 0.000081 | 5000.0 | Littérature scientif. (200-27 000 MJ/cm²) | 0.405000
market for wafer, fabricated, for integrated circuit | BCM54213PE GigE PHY QFP (8x8mm) | 6.4e-05 | square meter | ecoinvent-391-cutoff | ic | GLO | technosphere | 0 | (Unknown) | (Unknown) | (Unknown) | (Unknown) | (Unknown) | 0.000064 | 5000.0 | Littérature scientif. (200-27 000 MJ/cm²) | 0.320000
market for integrated circuit, memory type | EEPROM HAT ID SOIC-8 | 0.001 | kilogram | ecoinvent-391-cutoff | ic | GLO | technosphere | 0 | (Unknown) | (Unknown) | (Unknown) | (Unknown) | (Unknown) | 0.001000 | 80.7 | ADEME / Boavizta | 0.080700
market for integrated circuit, logic type | MxL7704 PMIC QFN (power management) | 0.003 | kilogram | ecoinvent-391-cutoff | ic | GLO | technosphere | 0 | (Unknown) | (Unknown) | (Unknown) | (Unknown) | (Unknown) | 0.003000 | 80.7 | ADEME / Boavizta (équip. réseau) | 0.242100
market for electric connector, peripheral type buss | Connecteur USB-C alimentation | 0.0022 | kilogram | ecoinvent-391-cutoff | peripherial | GLO | technosphere | 0 | (Unknown) | (Unknown) | (Unknown) | (Unknown) | (Unknown) | 0.002200 | 15.0 | Ecoinvent 3.9 (connecteurs électroniques) | 0.033000
market for electric connector, peripheral type buss | Connecteur micro-HDMI x2 | 0.00046 | kilogram | ecoinvent-391-cutoff | peripherial | GLO | technosphere | 0 | (Unknown) | (Unknown) | (Unknown) | (Unknown) | (Unknown) | 0.000460 | 15.0 | Ecoinvent 3.9 (connecteurs électroniques) | 0.006900
market for electric connector, peripheral type buss | Connecteurs USB-A 3.0 x2 + 2.0 x2 | 0.0122 | kilogram | ecoinvent-391-cutoff | peripherial | GLO | technosphere | 0 | (Unknown) | (Unknown) | (Unknown) | (Unknown) | (Unknown) | 0.012200 | 15.0 | Ecoinvent 3.9 (connecteurs électroniques) | 0.183000
market for electric connector, peripheral type buss | Connecteur RJ45 GigE avec LEDs | 0.006 | kilogram | ecoinvent-391-cutoff | peripherial | GLO | technosphere | 0 | (Unknown) | (Unknown) | (Unknown) | (Unknown) | (Unknown) | 0.006000 | 15.0 | Ecoinvent 3.9 (connecteurs électroniques) | 0.090000
market for electric connector, peripheral component interconnect buss | Header GPIO 40 pins 2.54mm | 0.00071 | kilogram | ecoinvent-391-cutoff | peripherial | GLO | technosphere | 0 | (Unknown) | (Unknown) | (Unknown) | (Unknown) | (Unknown) | 0.000710 | 15.0 | Ecoinvent 3.9 (connecteurs électroniques) | 0.010650
market for electric connector, peripheral component interconnect buss | Connecteurs DSI/CSI FPC x4 | 0.000206 | kilogram | ecoinvent-391-cutoff | peripherial | GLO | technosphere | 0 | (Unknown) | (Unknown) | (Unknown) | (Unknown) | (Unknown) | 0.000206 | 15.0 | Ecoinvent 3.9 (connecteurs électroniques) | 0.003090
market for electric connector, peripheral component interconnect buss | Slot microSD | 0.001 | kilogram | ecoinvent-391-cutoff | peripherial | GLO | technosphere | 0 | (Unknown) | (Unknown) | (Unknown) | (Unknown) | (Unknown) | 0.001000 | 15.0 | Ecoinvent 3.9 (connecteurs électroniques) | 0.015000
market for capacitor, for surface-mounting | capacitors 0402/0603/0805 | 0.00037 | kilogram | ecoinvent-391-cutoff | passive-component | GLO | technosphere | 0 | (Unknown) | (Unknown) | (Unknown) | (Unknown) | (Unknown) | 0.000370 | 15.0 | Ecoinvent 3.9 (composants passifs CMS) | 0.005550
market for capacitor, tantalum-, for through-hole mounting | capacitor tantalum filtrage | 6.3e-05 | kilogram | ecoinvent-391-cutoff | passive-component | GLO | technosphere | 0 | (Unknown) | (Unknown) | (Unknown) | (Unknown) | (Unknown) | 0.000063 | 15.0 | Ecoinvent 3.9 (composants passifs CMS) | 0.000945
market for resistor, surface-mounted | resistors 0402 | 9.9e-05 | kilogram | ecoinvent-391-cutoff | passive-component | GLO | technosphere | 0 | (Unknown) | (Unknown) | (Unknown) | (Unknown) | (Unknown) | 0.000099 | 15.0 | Ecoinvent 3.9 (composants passifs CMS) | 0.001485
market for inductor, low value multilayer chip | inductors 1008/1210 DC-DC | 0.000112 | kilogram | ecoinvent-391-cutoff | passive-component | GLO | technosphere | 0 | (Unknown) | (Unknown) | (Unknown) | (Unknown) | (Unknown) | 0.000112 | 15.0 | Ecoinvent 3.9 (composants passifs CMS) | 0.001680
market for diode, glass-, for surface-mounting | LED PWR + ACT SMD x2 | 0.00016 | kilogram | ecoinvent-391-cutoff | passive-component | GLO | technosphere | 0 | (Unknown) | (Unknown) | (Unknown) | (Unknown) | (Unknown) | 0.000160 | 15.0 | Ecoinvent 3.9 (composants passifs CMS) | 0.002400
market for transistor, surface-mounted | transistors/FETs SOT-23 alimentation | 6e-05 | kilogram | ecoinvent-391-cutoff | passive-component | GLO | technosphere | 0 | (Unknown) | (Unknown) | (Unknown) | (Unknown) | (Unknown) | 0.000060 | 15.0 | Ecoinvent 3.9 (composants passifs CMS) | 0.000900
market for resistor, surface-mounted | polyfuse resetable | 2.75e-05 | kilogram | ecoinvent-391-cutoff | passive-component | GLO | technosphere | 0 | (Unknown) | (Unknown) | (Unknown) | (Unknown) | (Unknown) | 0.000028 | 15.0 | Ecoinvent 3.9 (composants passifs CMS) | 0.000412
market for integrated circuit, logic type | quartz 25MHz Ethernet | 0.0006 | kilogram | ecoinvent-391-cutoff | ic | GLO | technosphere | 0 | (Unknown) | (Unknown) | (Unknown) | (Unknown) | (Unknown) | 0.000600 | 80.7 | ADEME / Boavizta (équip. réseau) | 0.048420
market for diode, glass-, for surface-mounting | diodes ESD/TVS protection ports | 6.6e-05 | kilogram | ecoinvent-391-cutoff | passive-component | GLO | technosphere | 0 | (Unknown) | (Unknown) | (Unknown) | (Unknown) | (Unknown) | 0.000066 | 15.0 | Ecoinvent 3.9 (composants passifs CMS) | 0.000990
TOTAL CO2eq estimé (fabrication) |  |  |  |  |  |  |  |  |  |  |  |  |  |  |  |  | 12.4965
