LeBaptCode/PolySource/RESSOURCES/Diapo_PolySource.pdf

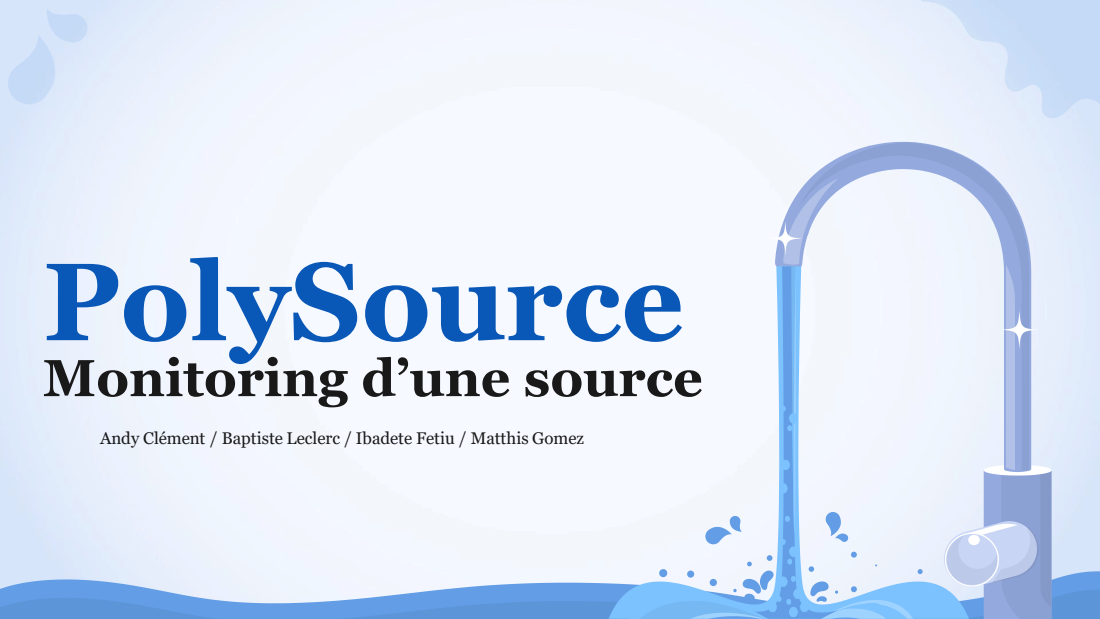
[picture p47: page 1]
PolySource

Monitoring d’une source

Andy Clément / Baptiste Leclerc / Ibadete Fetiu / Matthis Gomez

## Description du projet

## Configuration GSM & MQTT

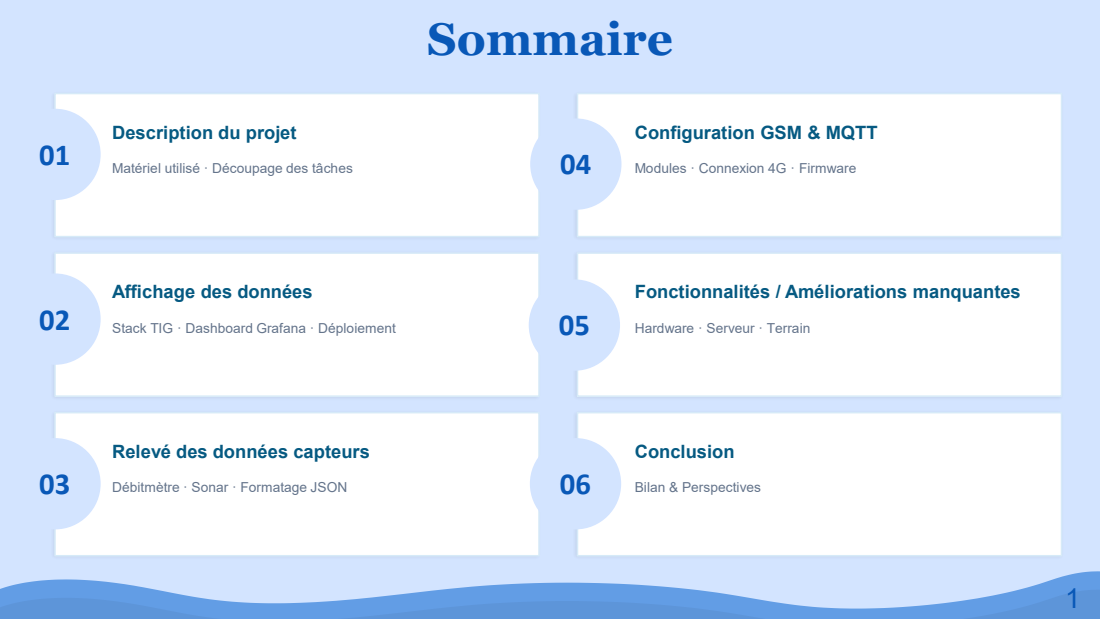
[picture p48: page 2]
Conclusion; Bilan & Perspectives; Sommaire

Matériel utilisé · Découpage des tâches

Modules · Connexion 4G · Firmware

Affichage des données

Fonctionnalités / Améliorations manquantes

Stack TIG · Dashboard Grafana · Déploiement

Hardware · Serveur · Terrain

Relevé des données capteurs

Débitmètre · Sonar · Formatage JSON

# Description du projet

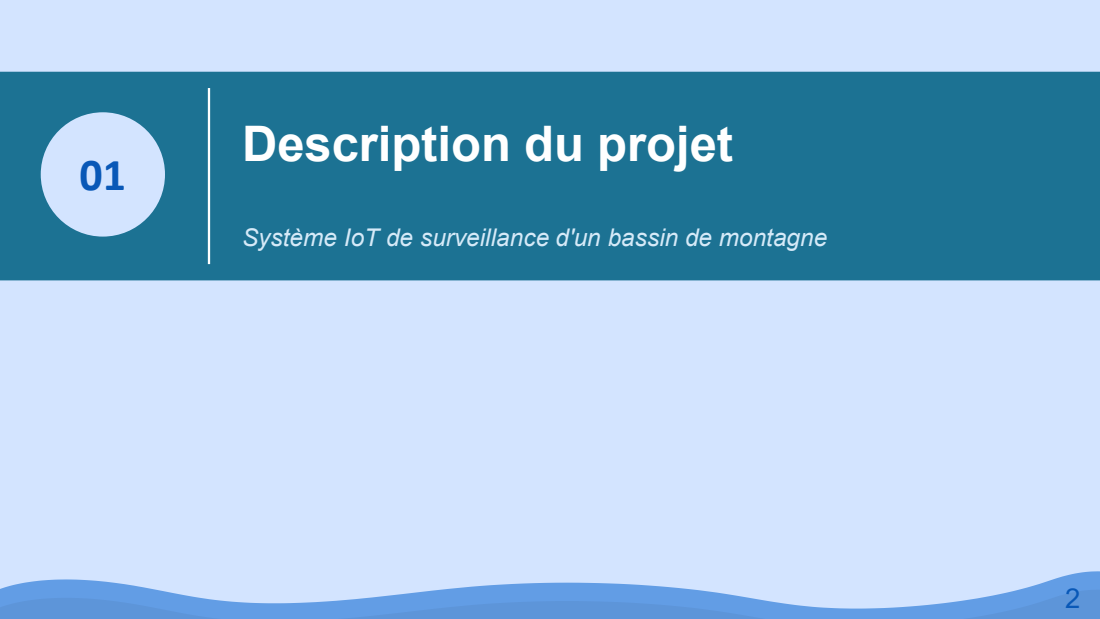
[picture p49: page 3]

Système IoT de surveillance d'un bassin de montagne

# 1. Description du projet — Vue d'ensemble

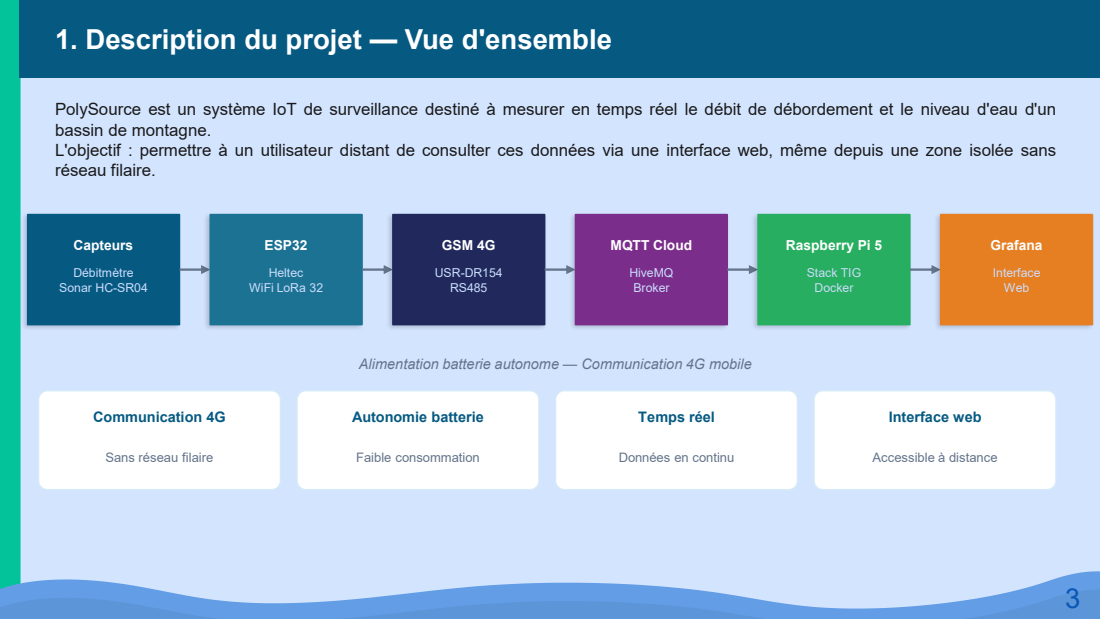
[picture p50: page 4]
Capteurs; Débitmètre Sonar HC-SR04; ESP32; Heltec WiFi LoRa 32; GSM 4G; USR-DR154 RS485; MQTT Cloud; HiveMQ Broker; Raspberry Pi 5; Stack TIG Docker; Grafana; Interface Web; Communication 4G; Autonomie batterie; Faible consommation; Temps réel; Interface web; Accessible à distance

PolySource est un système IoT de surveillance destiné à mesurer en temps réel le débit de débordement et le niveau d'eau d'un
bassin de montagne.
L'objectif : permettre à un utilisateur distant de consulter ces données via une interface web, même depuis une zone isolée sans
réseau filaire.

Alimentation batterie autonome — Communication 4G mobile

Sans réseau filaire

Données en continu

# 1. Description du projet — Vue d'ensemble

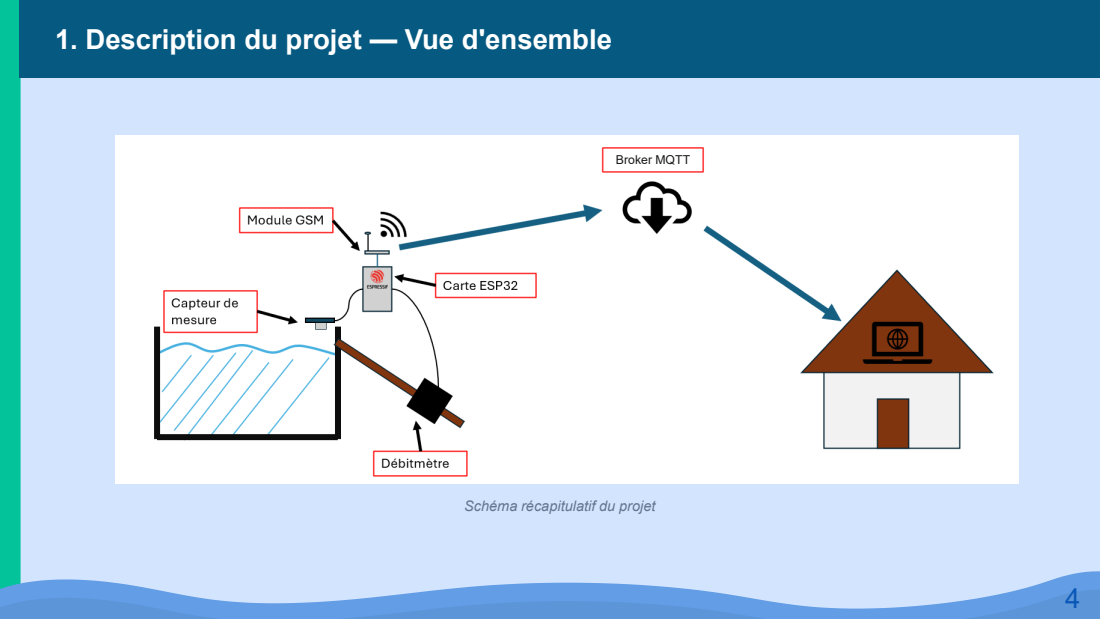
[picture p51: page 5]
Broker MQTT

Schéma récapitulatif du projet

# 1a. Matériel utilisé

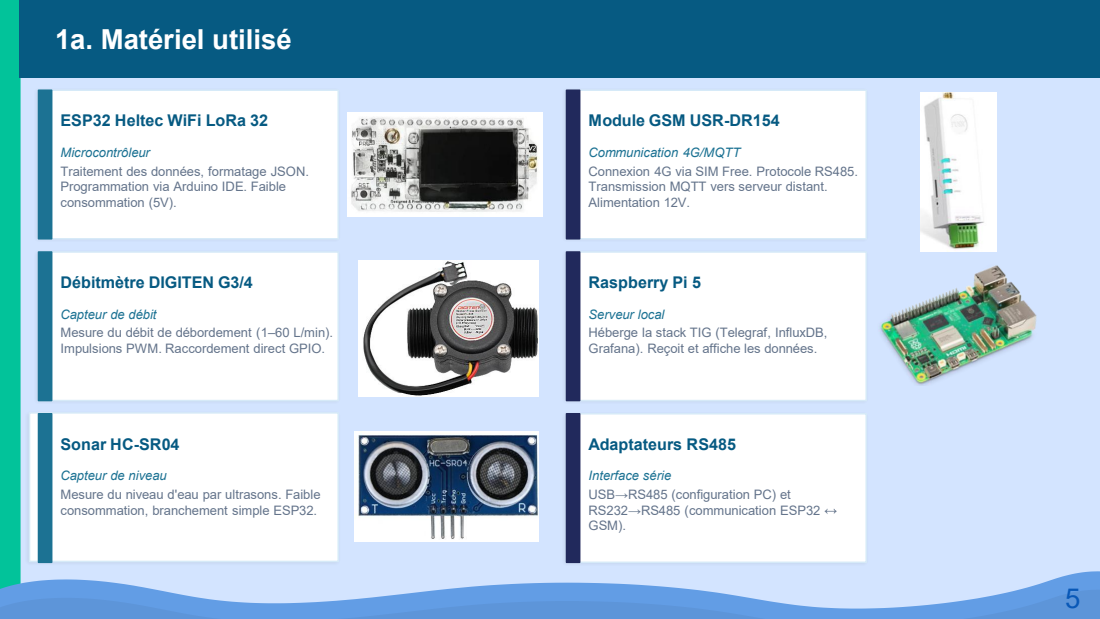
[picture p52: page 6]
Débitmètre DIGITEN G3/4; Sonar HC-SR04; Raspberry Pi 5; Adaptateurs RS485

ESP32 Heltec WiFi LoRa 32

Module GSM USR-DR154

Microcontrôleur
Traitement des données, formatage JSON.
Programmation via Arduino IDE. Faible
consommation (5V).

Communication 4G/MQTT
Connexion 4G via SIM Free. Protocole RS485.
Transmission MQTT vers serveur distant.
Alimentation 12V.

Capteur de débit
Mesure du débit de débordement (1–60 L/min).
Impulsions PWM. Raccordement direct GPIO.

Serveur local
Héberge la stack TIG (Telegraf, InfluxDB,
Grafana). Reçoit et affiche les données.

Capteur de niveau
Mesure du niveau d'eau par ultrasons. Faible
consommation, branchement simple ESP32.

Interface série
USB→RS485 (configuration PC) et
RS232→RS485 (communication ESP32
GSM).

# 1b. Découpage des tâches

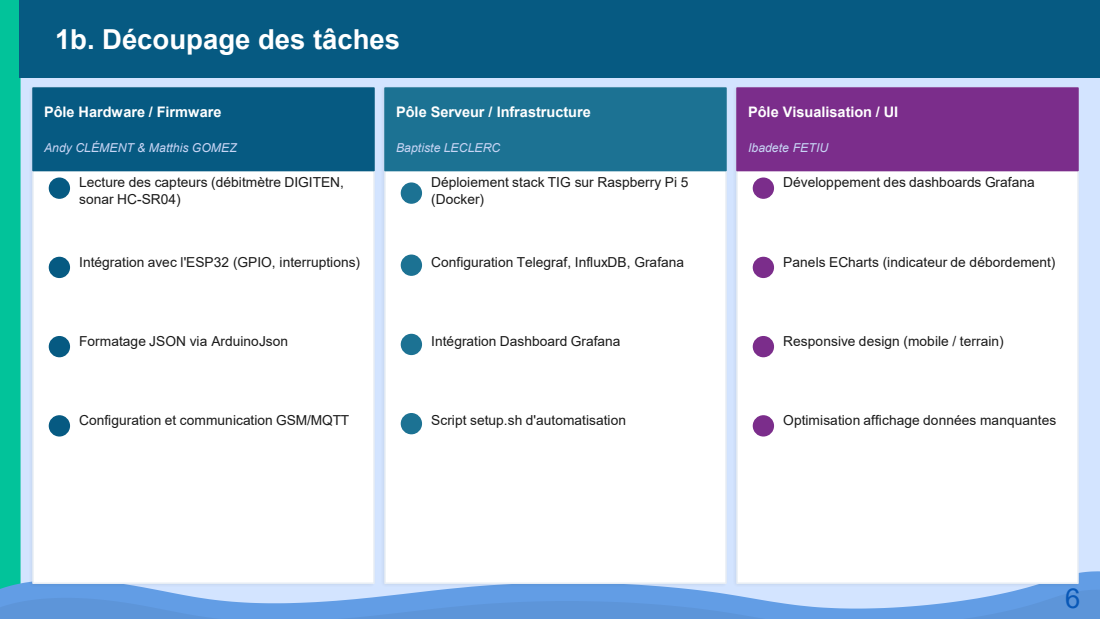
[picture p53: page 7]
Baptiste LECLERC; Ibadete FETIU

Pôle Hardware / Firmware

Pôle Serveur / Infrastructure

Pôle Visualisation / UI

Andy CLÉMENT & Matthis GOMEZ

Lecture des capteurs (débitmètre DIGITEN,
sonar HC-SR04)

Déploiement stack TIG sur Raspberry Pi 5
(Docker)

Développement des dashboards Grafana

Intégration avec l'ESP32 (GPIO, interruptions)

Configuration Telegraf, InfluxDB, Grafana

Panels ECharts (indicateur de débordement)

Formatage JSON via ArduinoJson

Intégration Dashboard Grafana

Responsive design (mobile / terrain)

Configuration et communication GSM/MQTT

Script setup.sh d'automatisation

Optimisation affichage données manquantes

# Affichage des données

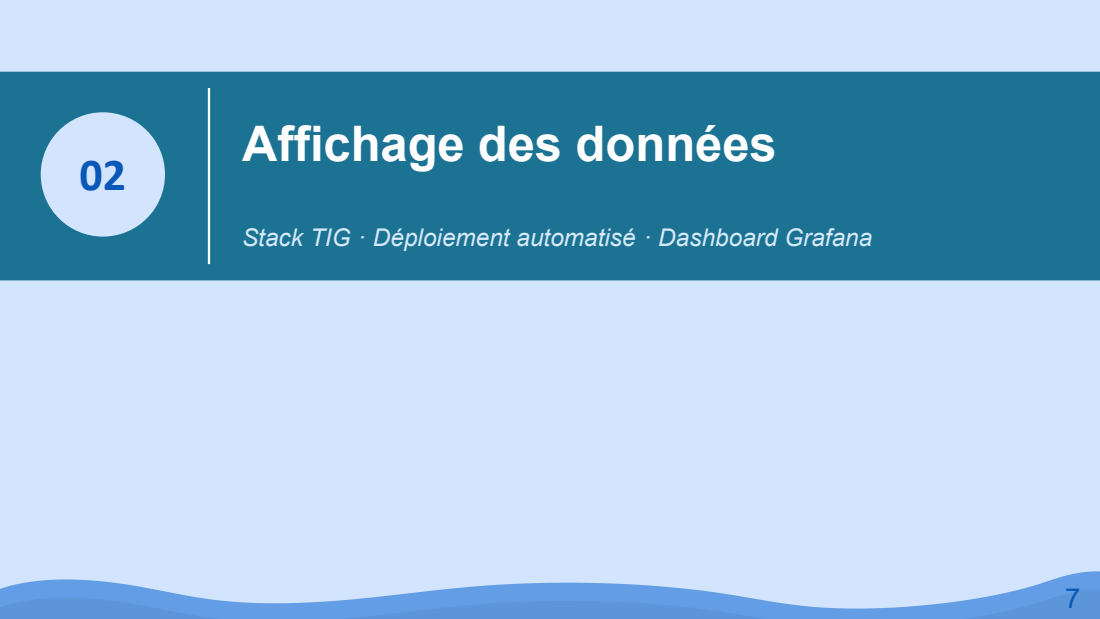
[picture p54: page 8]

Stack TIG · Déploiement automatisé · Dashboard Grafana

2. Affichage des données — Stack T.I.G.

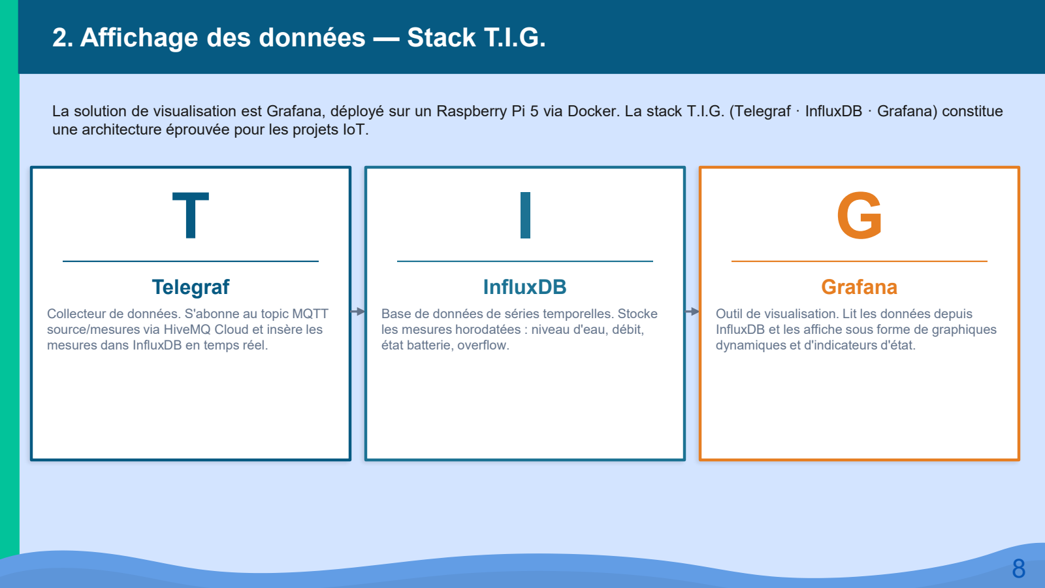
[picture p55: page 9]

La solution de visualisation est Grafana, déployé sur un Raspberry Pi 5 via Docker. La stack T.I.G. (Telegraf · InfluxDB · Grafana) constitue une architecture éprouvée pour les projets IoT.
T

## Telegraf

Collecteur de données. S'abonne au topic MQTT source/mesures via HiveMQ Cloud et insère les mesures dans InfluxDB en temps réel.

I

## InfluxDB

Base de données de séries temporelles. Stocke les mesures horodatées : niveau d'eau, débit, état batterie, overflow.

G

## Grafana

Outil de visualisation. Lit les données depuis InfluxDB et les affiche sous forme de graphiques dynamiques et d'indicateurs d'état.

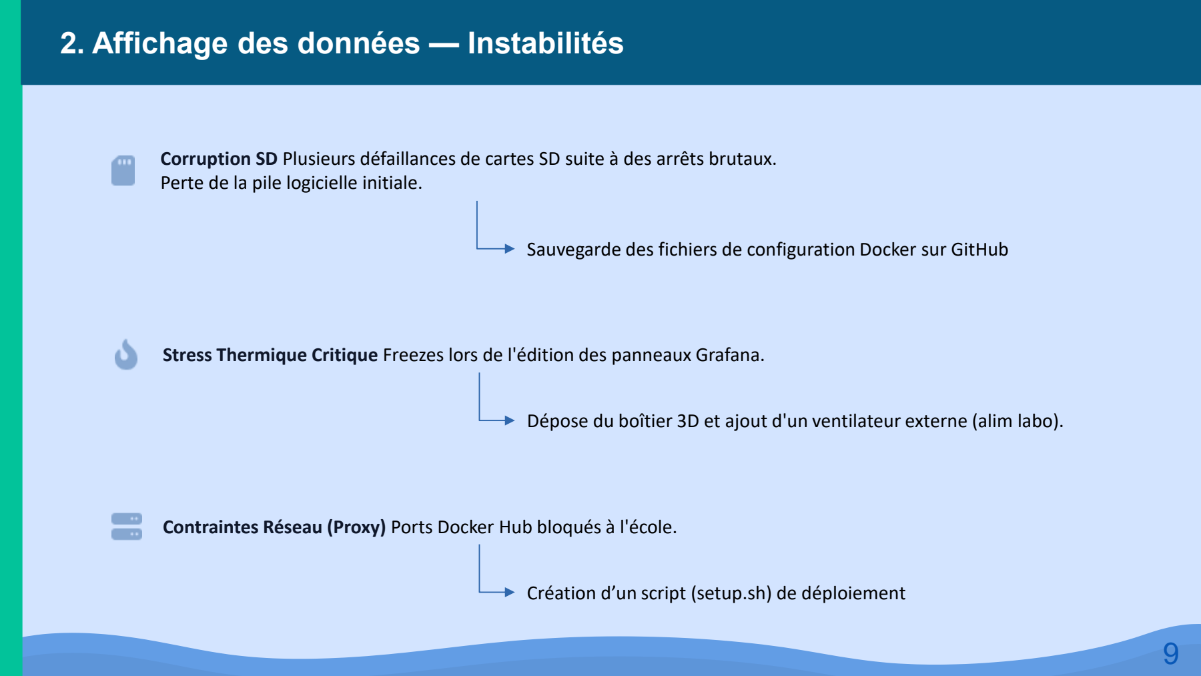
[picture p56: figure]
2. Affichage des données — Instabilités; Perte de la pile logicielle initiale.

Corruption SD Plusieurs défaillances de cartes SD suite à des arrêts brutaux.

## Sauvegarde des fichiers de configuration Docker sur GitHub

Stress Thermique Critique Freezes lors de l'édition des panneaux Grafana.

Dépose du boîtier 3D et ajout d'un ventilateur externe (alim labo).

Contraintes Réseau (Proxy) Ports Docker Hub bloqués à l'école.

## Création d’un script (setup.sh) de déploiement

# 2. Affichage des données — Déploiement automatisé

# setup.sh

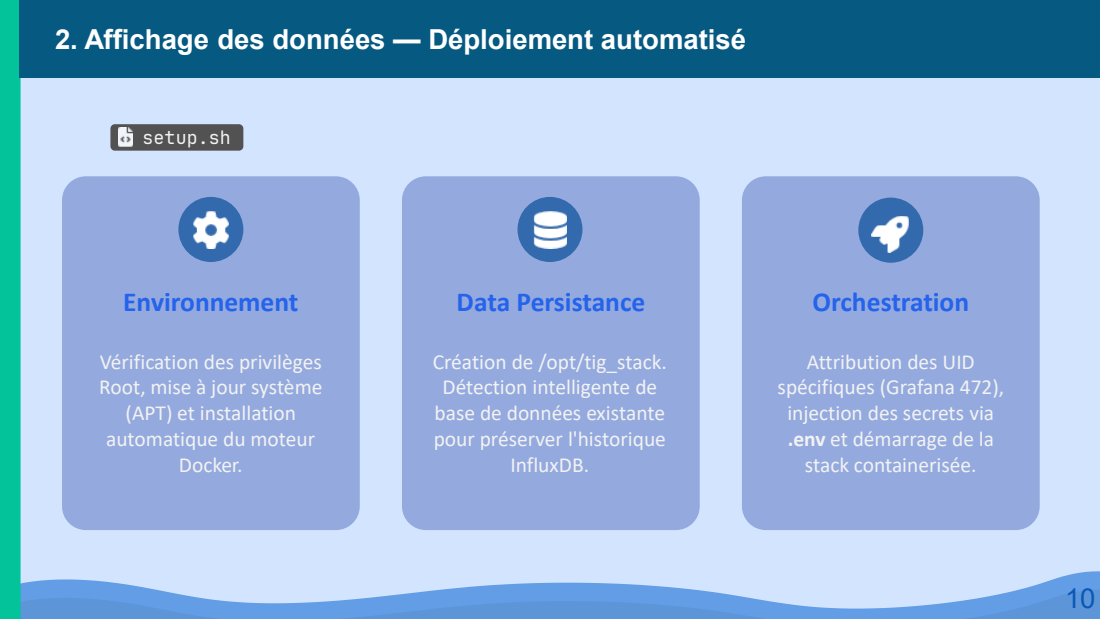
[picture p57: page 11]
Environnement; Data Persistance; Orchestration; Docker.; InfluxDB.

Vérification des privilèges
Root, mise à jour système
(APT) et installation
automatique du moteur

Création de /opt/tig_stack.
Détection intelligente de
base de données existante
pour préserver l'historique

Attribution des UID
spécifiques (Grafana 472),
injection des secrets via
.env et démarrage de la
stack containerisée.

# 2. Dashboard Grafana & Déploiement automatisé

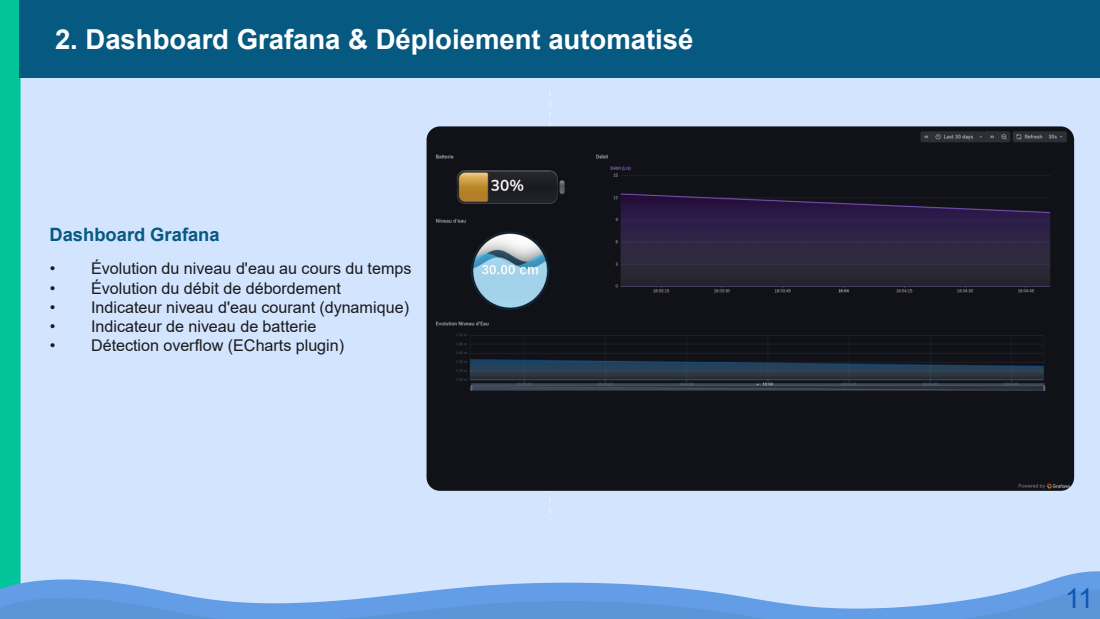
[picture p58: page 12]
Dashboard Grafana

• Évolution du niveau d'eau au cours du temps
• Évolution du débit de débordement
• Indicateur niveau d'eau courant (dynamique)
• Indicateur de niveau de batterie
• Détection overflow (ECharts plugin)

# Relevé des données capteurs

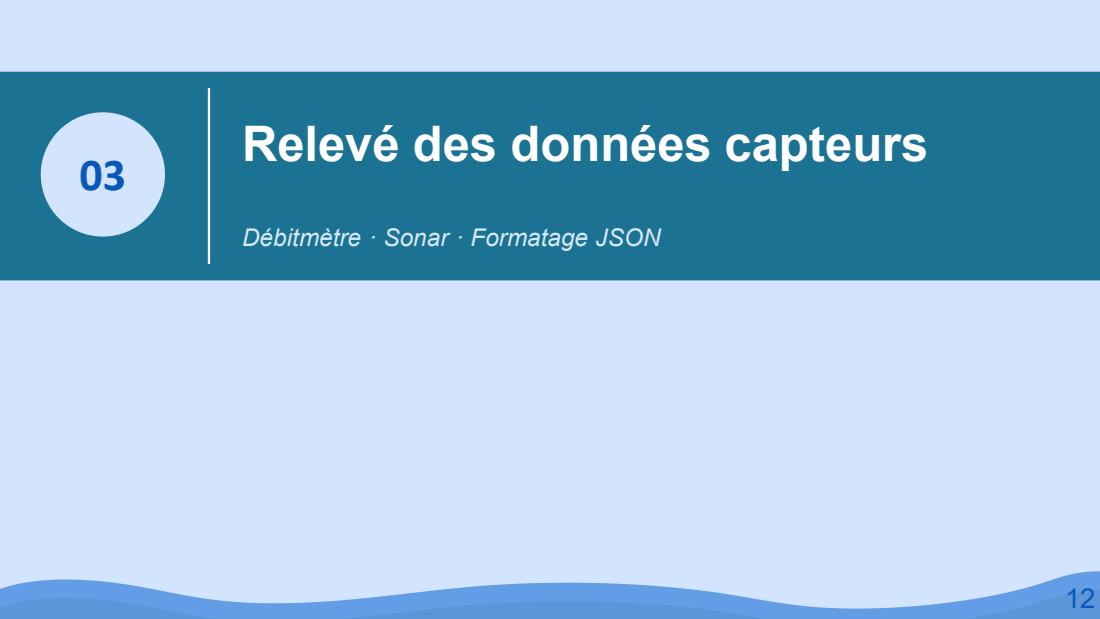
[picture p59: page 13]

Débitmètre · Sonar · Formatage JSON

# 3. Relevé des données — Capteurs

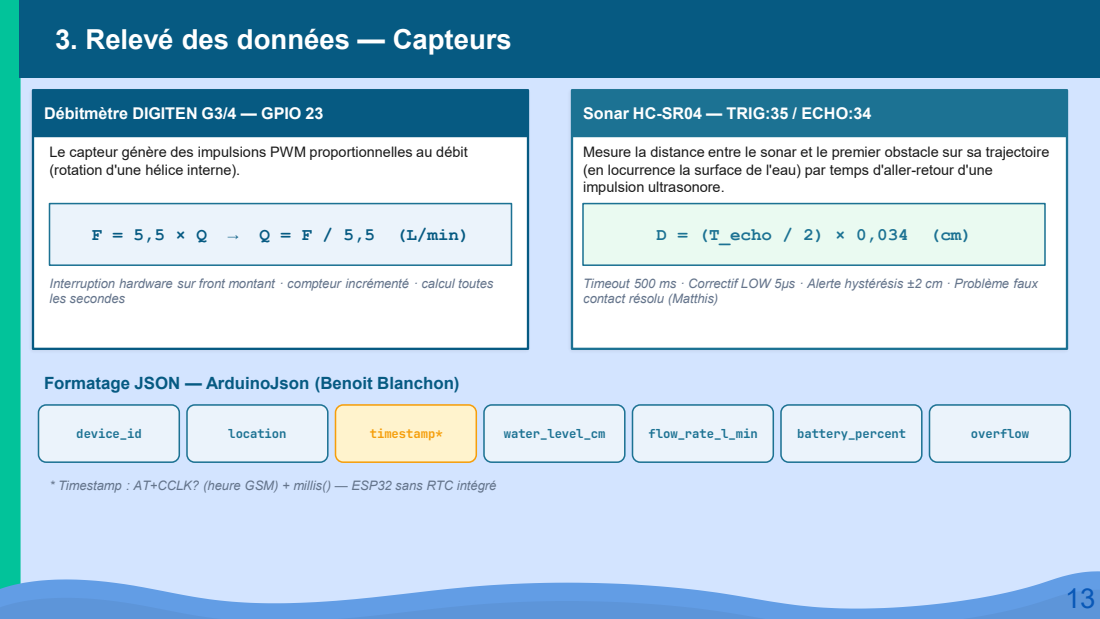
[picture p60: page 14]
(L/min); D = (T_echo / 2) × 0,034; device_id; location; timestamp*; water_level_cm; flow_rate_l_min; battery_percent; overflow

Débitmètre DIGITEN G3/4 — GPIO 23

Sonar HC-SR04 — TRIG:35 / ECHO:34

Le capteur génère des impulsions PWM proportionnelles au débit
(rotation d'une hélice interne).

Mesure la distance entre le sonar et le premier obstacle sur sa trajectoire
(en locurrence la surface de l'eau) par temps d'aller-retour d'une
impulsion ultrasonore.

Interruption hardware sur front montant · compteur incrémenté · calcul toutes
les secondes

Timeout 500 ms · Correctif LOW 5µs · Alerte hystérésis ±2 cm · Problème faux
contact résolu (Matthis)

Formatage JSON — ArduinoJson (Benoit Blanchon)

* Timestamp : AT+CCLK? (heure GSM) + millis() — ESP32 sans RTC intégré

# 3. Relevé des données — Capteurs

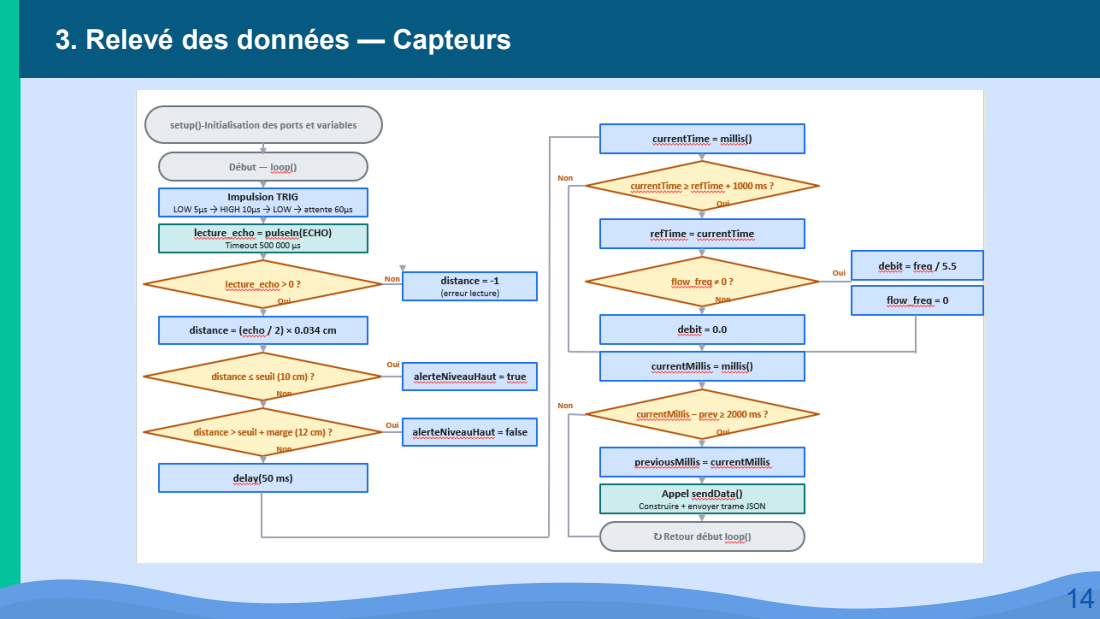
[picture p61: page 15]

# Configuration GSM & MQTT

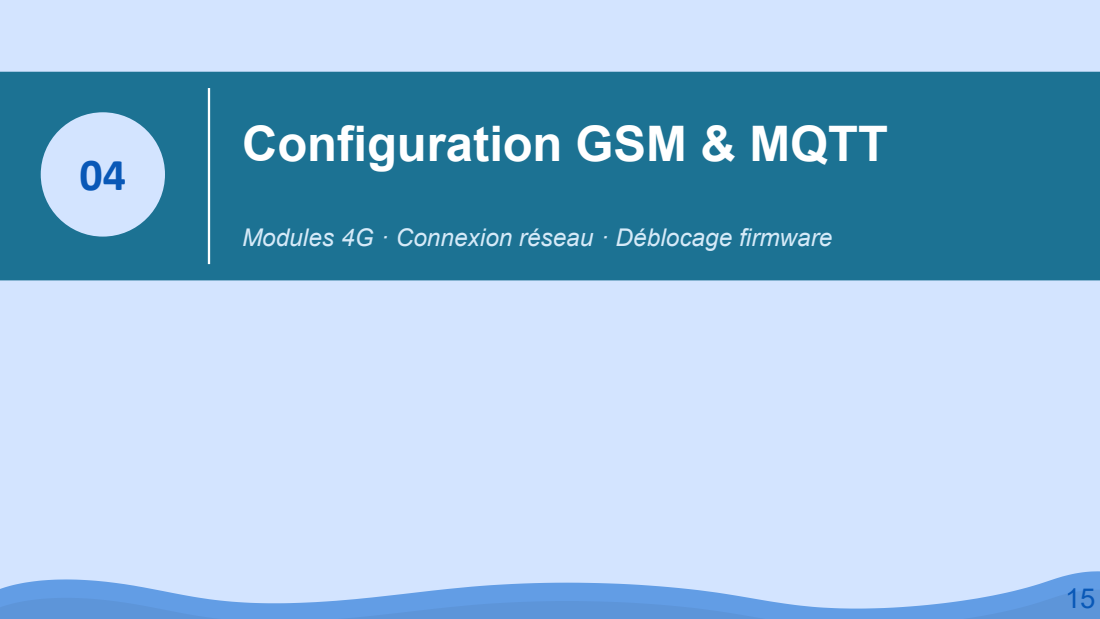
[picture p62: page 16]

Modules 4G · Connexion réseau · Déblocage firmware

# 4. Configuration GSM et connexion au broker MQTT

## Travail effectué

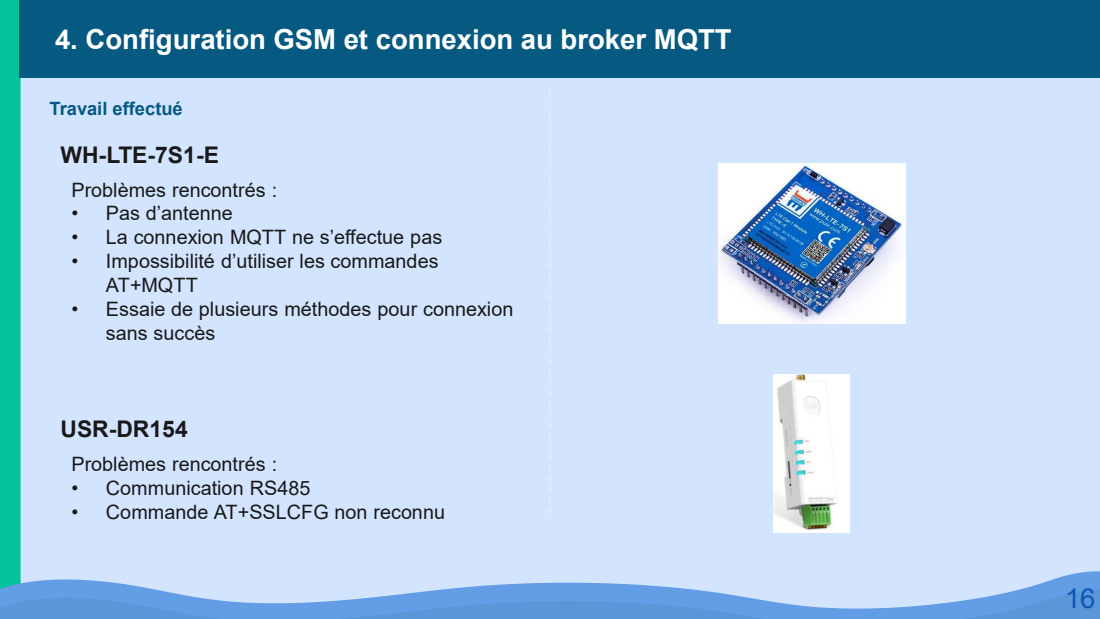
[picture p63: page 17]
WH-LTE-7S1-E; USR-DR154

Problèmes rencontrés :
• Pas d’antenne
• La connexion MQTT ne s’effectue pas
• Impossibilité d’utiliser les commandes
AT+MQTT
• Essaie de plusieurs méthodes pour connexion
sans succès

• Communication RS485
• Commande AT+SSLCFG non reconnu

# 4. Configuration GSM et connexion au broker MQTT

## Modules évalués

WH-LTE-7S1-E — Écarté ✗

Pas de commande AT+MQTT dans la bibliothèque. Configuration manuelle impossible. Module abandonné.

USR-DR154 — Retenu ✓

Protocole RS485. Plus simple à déboguer. Commandes AT+MQTT disponibles après mise à jour firmware.

Adaptateurs nécessaires (ESP32 sans RS485 natif) :

- USB → RS485 : configuration depuis PC (logiciel PV-DTUSet)
- | RS232 → RS485 : communication ESP32 | USR-DR154

### Séquence de configuration MQTT (TLS port 8883)

### AT+WKMOD=MQTT,NOR

### AT+MQTTSVR=<adresse>.eu.hivemq.cloud,8883

### AT+MQTTUSER=<identifiant>

## AT+MQTTPSW=<mot_de_passe>

### AT+MQTTCID=USR-DR154

### AT+SSLEN=ON

### AT+SSLCFG=ON

## AT+SSLAUTH=NONE

Défi technique majeur : AT+SSLCFG non reconnue par le firmware d'origine. Firmware mis à jour (support PUSR, 10/04/2026) → connexion HiveMQ Cloud réussie (LED NET visible sur le module).

Connexion au réseau 4G :

- Configuration de l’APN free. Reconnue par le réseau

# Fonctionnalités / Améliorations manquantes

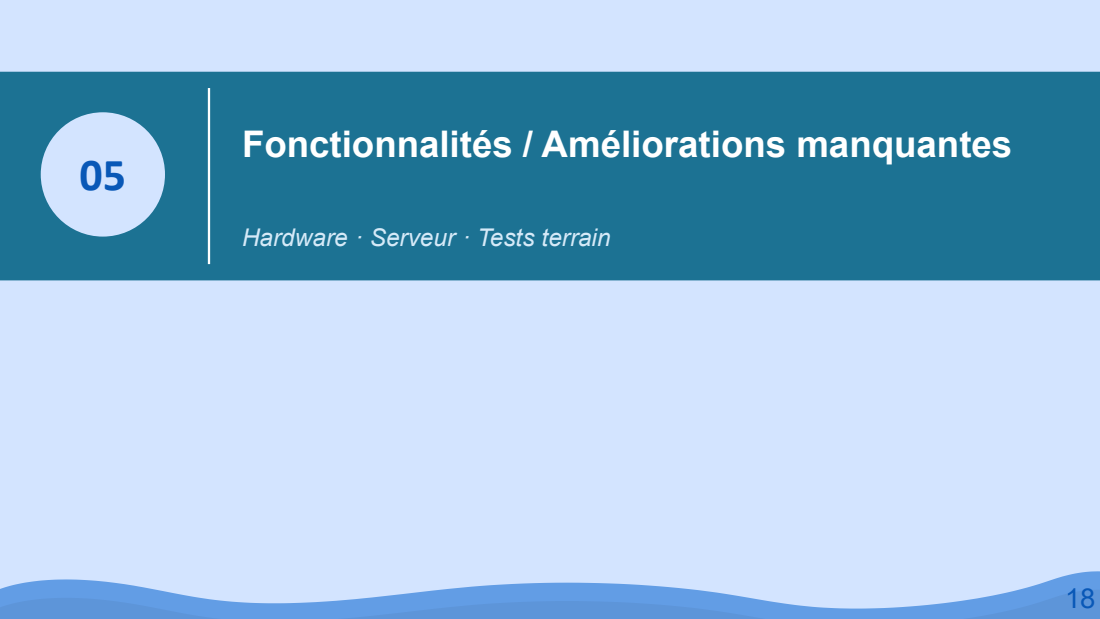
[picture p64: page 19]

Hardware · Serveur · Tests terrain

# 5. Fonctionnalités / Améliorations manquantes

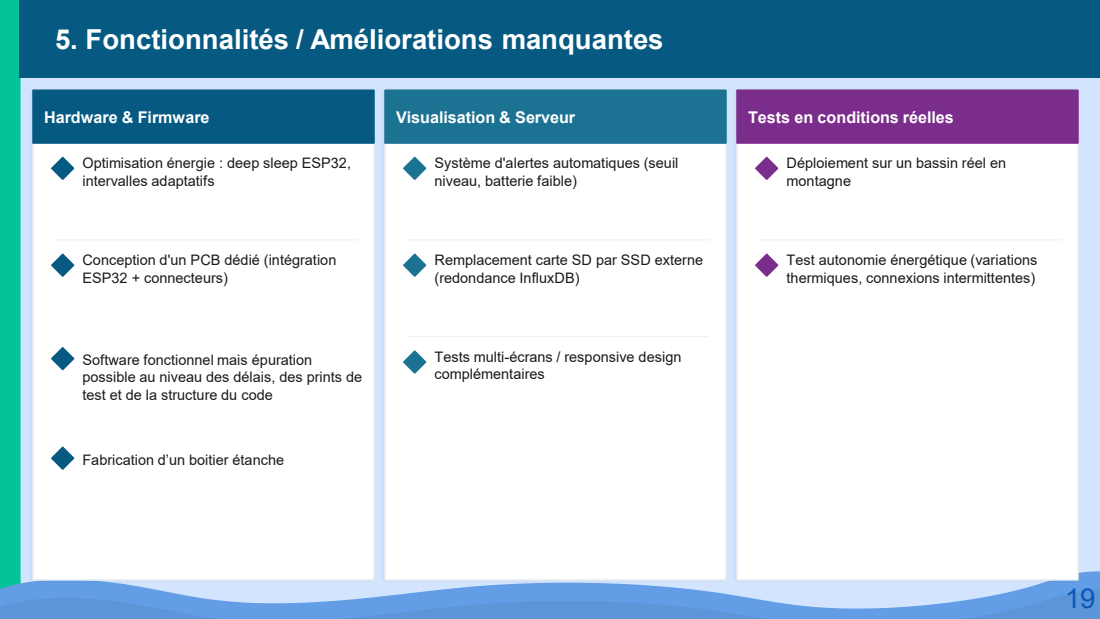
[picture p65: page 20]
Hardware & Firmware; Visualisation & Serveur

Tests en conditions réelles

Optimisation énergie : deep sleep ESP32,
intervalles adaptatifs

Système d'alertes automatiques (seuil
niveau, batterie faible)

Déploiement sur un bassin réel en
montagne

Conception d'un PCB dédié (intégration
ESP32 + connecteurs)

Remplacement carte SD par SSD externe
(redondance InfluxDB)

Test autonomie énergétique (variations
thermiques, connexions intermittentes)

Software fonctionnel mais épuration
possible au niveau des délais, des prints de
test et de la structure du code

Tests multi-écrans / responsive design
complémentaires

Fabrication d’un boitier étanche

# Conclusion

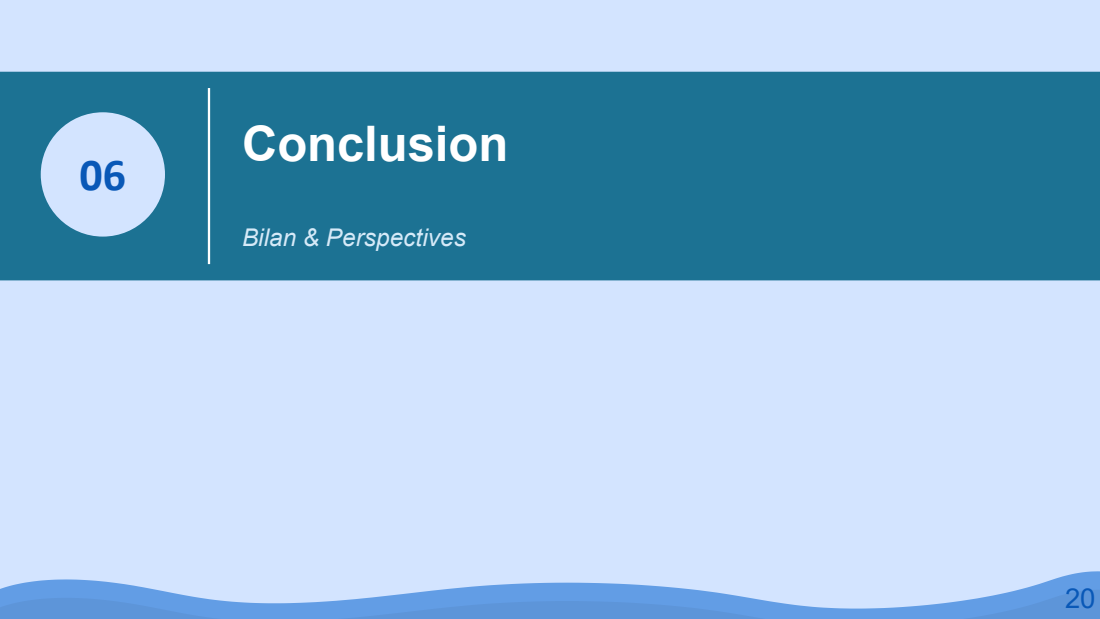
[picture p66: page 21]
Bilan & Perspectives

# 6. Bilan

✓
Acquisition fonctionnelle des deux capteurs (débitmètre + sonar) avec formatage JSON et horodatage

✓
Connexion GSM USR-DR154 au broker MQTT HiveMQ Cloud après mise à jour firmware

✓
Stack TIG (Telegraf, InfluxDB, Grafana) déployée sur Raspberry Pi 5 via Docker avec automatisation complète

✓
Dashboard Grafana opérationnel : niveau d'eau, débit, batterie, indicateur de débordement

✓
Validation end-to-end de la chaîne complète en conditions quasi-réelles

github.com/LeBaptCode/PolySource — Code source, documentation, tutoriels et ressources techniques disponibles.

# Merci de votre attention

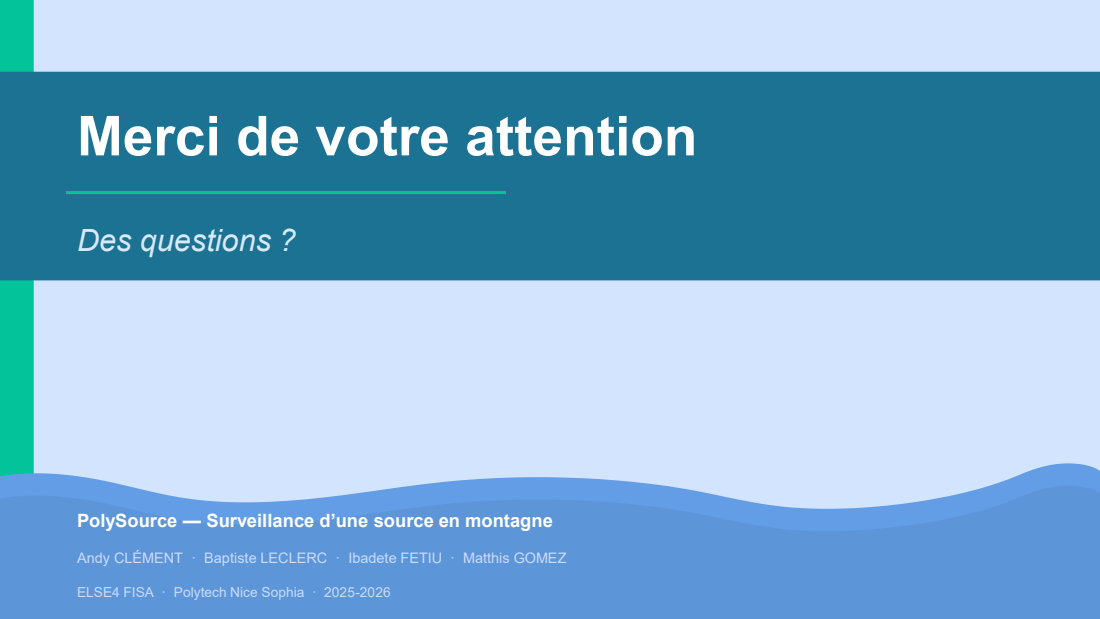
[picture p67: page 23]
Des questions ?

PolySource — Surveillance d’une source en montagne

Andy CLÉMENT · Baptiste LECLERC · Ibadete FETIU · Matthis GOMEZ

ELSE4 FISA · Polytech Nice Sophia · 2025-2026
