LeBaptCode/PolySource/(commit log)

2025-11-04 Code De la polySource
2025-11-12 Ajout du rapport de la séance du 12/11
2025-11-27 Ajout du rapport de la séance de 27/11/2025
2025-11-28 Ajout du rapport de la séance du 28/11/2025
2025-12-11 Ajout du rapport de la séance du 11/12/2025
2026-01-21 Ajout du rapport des séances du 20-21/01/2026
2026-02-03 Document session report on Grafana setup and adjustments
    Recreated Grafana dashboards and finalized overflow indicator on Raspberry Pi.
2026-02-06 Ajout du rapport de la séance du 03/02/2026
2026-02-17 Ajout du rapport de la séance du 17/02/2026
2026-02-20 Ajout du rapport de la séance du 19/02/2026
2026-03-08 Ajout du rapport de la séance du 05/03/2026
2026-03-17 Add battery gauge visualization for Grafana
    This file implements a battery gauge visualization for Grafana, including color coding based on battery percentage and graphical elements for display.
2026-03-17 Add water level visualization script for Grafana
    This script retrieves numeric values from Grafana, calculates the water level as a fraction of maximum sonar height, and configures a liquid fill visualization.
2026-03-17 Ajout du rapport de la séance du 17/03/2026
2026-04-03 Grafana Dashboard file
    Added a new Grafana dashboard configuration for PolySource, including multiple panels for battery level, flow rate, and water level.
2026-04-04 Ajout du rapport de la séance du 03/04/2026
2026-04-11 Ajout du rapport de la séance du 10/04/2026
2026-04-21 Excel d'analyse
    [Analyse_ACV.xlsx]
2026-04-21 Add session report on Grafana dashboard reconstruction
    This document outlines the objectives, actions taken, and results achieved during the session focused on reconstructing the Grafana dashboard and improving system supervision on Raspberry Pi. It includes details on data management, visualization optimizations, and initial considerations for an alert management system.
2026-04-21 Add session report on Raspberry Pi stability analysis
    This document details the analysis of stability issues encountered with the Raspberry Pi, focusing on performance and thermal management. It outlines observations, potential bottlenecks, and optimization strategies for improving system reliability.
2026-04-21 Plus de technique
2026-04-23 Supression Doublon
    [Analyse_ACV.xlsx]
2026-04-24 Add setup script for Raspberry Pi with Docker installation and configuration
2026-04-24 feat: Update Docker configuration and provisioning for Grafana and InfluxDB
    - Added .env to .gitignore for sensitive environment variables.
    - Enhanced docker-compose.yml with environment variables for InfluxDB, Grafana, and Telegraf.
    - Updated Telegraf configuration to use environment variables for MQTT and InfluxDB credentials.
    - Created a new Grafana dashboard JSON file for visualizing battery and flow rate data.
    - Added a dashboard provisioning YAML file for Grafana to load dashboards from the specified path.
    - Introduced a datasource YAML file for Grafana to connect to InfluxDB with secure token handling.
2026-04-24 Update Code-Controle-Source.ino
    Correction bug sonar, timeout nécessaire pour que la fonction pulseIn fasse son travail correctement
    [Code-Controle-Source.ino]
2026-04-25 Ajout du rapport de la séance du 24/04/2026
2026-05-17 docs: ajout des livrables finaux du projet
    - Ajout du rapport final
    - Ajout du diaporama de la soutenance
