LeBaptCode/PolySource/DOCS/AndyCLEMENT/Images/SIM-Card-work.JPG

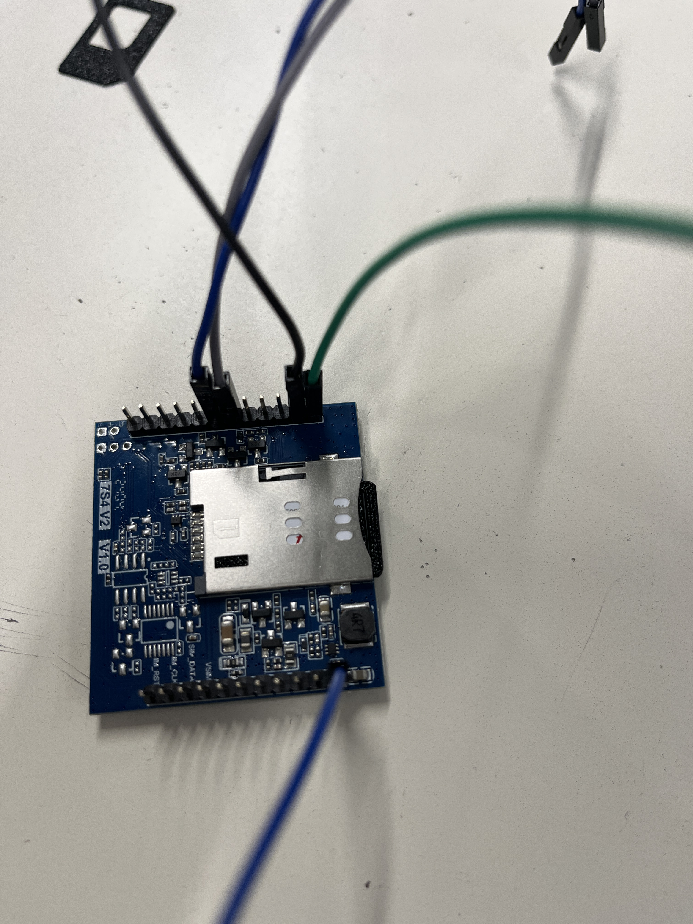
[picture p9: DOCS/AndyCLEMENT/Images/SIM-Card-work.JPG]
DOCS/AndyCLEMENT/Images/SIM-Card-work.JPG
